eugenewang5425/MicroDinosaur/PROJECT_STATUS.md

# MicroDinosaur 项目状态

截至 2026-11-07。本页区分机械、台架测量和设计候选，不将通信或软件检查视为整机性能。

| 模块 | 已完成 | 当前限制与下一步 |
| --- | --- | --- |
| 机械/打印 | 当前 OS-M02 整机与 8 盘 30 件原生工程；四处 Ø1.8 mm 导孔修正与切片检查 | 相机孔距、卡扣、轴承及 M2 咬合待试装，承载和完整运动待验 |
| 校准架 | 已设计分体架体和可拔定位件，形成模型及打印文件 | 尚未实物试装，站立零位未实机测试；本包不混入姿态参考或工装试验副本 |
| IMU | F411 的静置/手动动作读取，ZERO 3W 的 250/250 次读取 | 两路都见约 ±15.6°/s 跳点；需核查上拉、读数一致性、波形及安装轴向 |
| 头部 HAT | 最新 B2 V3 六层工程；279 过孔，DRC 0 错误/0 警告/0 未连接 | 未打样；阻抗、载流、温升、电平、USB 改焊、驱动和整机空间待验证 |
| 感知 | 焊接修复后相机、NPU、Wi-Fi 及蓝牙功能复测正常；输入转换保真优化已完成 | 本周无新增持续帧率成绩；散热配件未购，安装后复测 5 分钟性能 |
| 站立/行走 | 已有调试与策略研究基础 | 现有 HAT 供电不兼容，实机策略测试推迟；不宣称站立或行走通过 |

## 最近的可核对测量

F411 在 5 µs 软件时序等待下静置读取 214/214 成功，手动动作 256/256 成功；ZERO 3W 约 5 秒读取 250/250 成功。事务成功不证明传感器精度或原子采样，原始异常点保留在 [IMU 数据](hardware/imu/README.md)。

感知固定为 640×360 相机、256×256 模型输入和 JPEG82。原生 INT8 输入搬运在既有对照中保持深度/JPEG 逐字节一致，配对净省约 10.72 ms/帧。裸板短测网页约 19.95 fps，但未通过完整 300 秒目标；热稳性能仍待散热后复测，详见 [感知说明](software/perception/README.md)。

## 当前发布范围

默认分支仅保留最新 CAD、打印工程、HAT 原生项目、对应主机代码、IMU 读取程序、当前感知代码与所用权重，以及少量最终验证结果。旧 CAD、旧仿真策略、历史对照、过程日志和工具环境不在当前文件树中；已经提交的历史可通过 Git 历史查看。

历史 v07 仿真使用独立模型、质量和控制定义，不能套用到 OS-M02。本次未把它作为当前模型附带，也未启动训练、访问电机或改变实机配置。
