eugenewang5425/MicroDinosaur/simulation/research/20260914_head_attitude/TABLES.md

# 全部确认组

| 条件/策略/任务/模式 | 完成/尝试 | 相机朝向RMS° | 周期偏航RMS° | 偏航角速RMS°/s | 俯仰RMS° | 横滚RMS° | 速度m/s | 跌倒 |
|---|---:|---:|---:|---:|---:|---:|---:|---:|
| head_mass_110pct__v7__straight__imu | 1/1 | 1.121 | 0.600 | 9.316 | 1.001 | 4.236 | 0.246 | 0 |
| head_mass_110pct__v7__straight__off | 1/1 | 3.022 | 1.392 | 20.574 | 2.555 | 5.333 | 0.246 | 0 |
| imu_40_60ms__v7__straight__imu | 1/1 | 2.326 | 1.580 | 22.623 | 1.537 | 5.559 | 0.230 | 0 |
| imu_40_60ms__v7__straight__off | 1/1 | 2.947 | 2.773 | 19.616 | 2.754 | 5.537 | 0.231 | 0 |
| imu_outage_200ms__v7__straight__imu | 1/1 | 2.330 | 0.676 | 9.445 | 1.266 | 5.432 | 0.230 | 0 |
| imu_outage_200ms__v7__straight__off | 1/1 | 5.160 | 1.437 | 19.895 | 2.740 | 5.552 | 0.231 | 0 |
| imu_residual_0p5deg_s__v7__straight__imu | 1/1 | 2.565 | 0.622 | 9.284 | 0.933 | 4.458 | 0.229 | 0 |
| imu_residual_0p5deg_s__v7__straight__off | 1/1 | 2.987 | 1.849 | 19.671 | 2.773 | 5.541 | 0.231 | 0 |
| motor_15ms__v7__straight__imu | 1/1 | 0.689 | 0.613 | 8.890 | 1.362 | 5.049 | 0.228 | 0 |
| motor_15ms__v7__straight__off | 1/1 | 3.056 | 1.449 | 18.796 | 2.684 | 5.871 | 0.229 | 0 |
| motor_5ms__v7__straight__imu | 1/1 | 1.200 | 0.914 | 10.842 | 1.110 | 4.367 | 0.225 | 0 |
| motor_5ms__v7__straight__off | 1/1 | 5.229 | 2.858 | 22.024 | 2.656 | 5.241 | 0.223 | 0 |
| nominal__s42_no_neck__left_then_hold__imu | 3/3 | 0.818 | 0.679 | 11.120 | 1.666 | 3.972 | 0.202 | 0 |
| nominal__s42_no_neck__left_then_hold__off | 3/3 | 2.186 | 1.964 | 26.473 | 3.177 | 3.910 | 0.204 | 0 |
| nominal__s42_no_neck__right_then_hold__imu | 3/3 | 0.928 | 0.801 | 12.243 | 1.968 | 4.006 | 0.203 | 0 |
| nominal__s42_no_neck__right_then_hold__off | 3/3 | 2.305 | 2.090 | 27.444 | 3.257 | 3.854 | 0.205 | 0 |
| nominal__s42_no_neck__stand__imu | 3/3 | 0.217 | 0.148 | 2.282 | 1.917 | 0.407 | 0.000 | 0 |
| nominal__s42_no_neck__stand__off | 3/3 | 1.437 | 0.390 | 1.604 | 4.572 | 0.421 | 0.000 | 0 |
| nominal__s42_no_neck__straight__filter_only | 3/3 | 2.846 | 2.022 | 14.231 | 3.059 | 5.073 | 0.270 | 0 |
| nominal__s42_no_neck__straight__imu | 3/3 | 0.895 | 0.722 | 12.085 | 2.294 | 4.334 | 0.270 | 0 |
| nominal__s42_no_neck__straight__off | 3/3 | 2.507 | 2.120 | 30.384 | 3.099 | 4.685 | 0.272 | 0 |
| nominal__v7__left_then_hold__imu | 3/3 | 0.797 | 0.703 | 7.519 | 0.682 | 3.708 | 0.167 | 0 |
| nominal__v7__left_then_hold__off | 3/3 | 3.917 | 2.630 | 19.579 | 2.975 | 4.406 | 0.167 | 0 |
| nominal__v7__right_then_hold__imu | 3/3 | 1.025 | 0.801 | 8.301 | 0.900 | 3.756 | 0.165 | 0 |
| nominal__v7__right_then_hold__off | 3/3 | 5.029 | 3.305 | 20.590 | 3.336 | 4.289 | 0.164 | 0 |
| nominal__v7__stand__imu | 3/3 | 0.494 | 0.111 | 1.463 | 0.516 | 1.892 | -0.000 | 0 |
| nominal__v7__stand__off | 3/3 | 1.903 | 0.002 | 0.082 | 1.321 | 2.793 | -0.000 | 0 |
| nominal__v7__straight__filter_only | 3/3 | 4.349 | 1.428 | 12.230 | 2.838 | 5.386 | 0.227 | 0 |
| nominal__v7__straight__imu | 3/3 | 1.372 | 0.617 | 9.137 | 0.970 | 4.429 | 0.230 | 0 |
| nominal__v7__straight__off | 3/3 | 4.567 | 1.467 | 19.807 | 2.752 | 5.544 | 0.231 | 0 |
| physics_0p625ms__v7__straight__imu | 1/1 | 1.423 | 0.627 | 9.101 | 0.918 | 4.395 | 0.231 | 0 |
| physics_0p625ms__v7__straight__off | 1/1 | 4.096 | 1.458 | 19.561 | 2.776 | 5.505 | 0.229 | 0 |
| pitch_scan__v7__straight__imu | 1/1 | 1.284 | 0.624 | 9.250 | 2.498 | 4.470 | 0.230 | 0 |
| position_40ms__v7__straight__imu | 1/1 | 0.807 | 0.514 | 7.157 | 0.956 | 4.515 | 0.226 | 0 |
| position_40ms__v7__straight__off | 1/1 | 2.765 | 1.145 | 14.999 | 2.534 | 5.683 | 0.225 | 0 |
| roll_scan__v7__straight__imu | 1/1 | 1.240 | 0.623 | 9.154 | 0.953 | 4.364 | 0.230 | 0 |
| yaw_scan__v7__straight__imu | 1/1 | 7.106 | 4.918 | 10.754 | 0.999 | 4.353 | 0.230 | 0 |
