eugenewang5425/MicroDinosaur/simulation/research/20260914_run_jump/PLAN.md

# 跑跳专项，2026-09-14

用户最新指令：台阶训练暂时不管，转向跑跳。ToF、台阶专家接管与视觉触发工作暂停。

本轮建立两个独立专项模型，原生产模型冻结。共享起点为 `microdinosaur_demo_demonstration/20260914_train_512x101/model_16250.pt`，源文件不改；不再加旧技能教师约束，避免要求一个模型同时保留所有旧动作。

## 两个任务

- **run**：平地0.45–0.80m/s指令，0–1秒站立、1–7秒加速行走、7–10秒发出停止请求；保留速度/航向/足部评分并增加小幅腾空奖励。实际速度与双脚腾空分开记录，没有腾空只称快走。
- **jump**：6秒一轮，0–1.5秒身体Z指令−3cm，1.5–2.2秒＋2cm，随后回零。没有示范关节轨迹、外力弹射或空中出生；从已校准站立状态探索蹬伸。奖励上升速度最大进展、合格姿态下无支撑时间最大进展与腾空后的落稳，不因抬脚本身认定跳跃，不重复支付旧的最大进展。

继续81维输入、19关节输出，nominal Kp7/Kd0.8（协议编码后7.0156/0.800299），物理步1.25ms、控制20ms、电机目标5–15ms、位置20–40ms、速度20ms。S288力矩随机降额范围0.48–0.60Nm；增益、质量/惯量、摩擦、编码器与IMU扰动保留。没有零延迟/零阻尼或ERPO。头部IMU继续负责头姿态，头yaw采用编码器基准，pitch/roll保持策略基准与IMU修正。

使用当前v07视觉包络生成的既有保守身体地面碰撞盒；质量仍1.0982148kg，未修改CAD。身体接地终止该次跑跳，不把头/尾支地算腾空或正常落地。碰撞盒不是完整关节自碰撞和实物强度证明。三个3秒站立物理检查通过，未接触身体代理，倾斜0.77–0.87°。

## 训练与事先固定的验收

两次64×5短训已完成并导出归一化ONNX。正式固定LR1e-4，小跳seed51、512×401；快速运动seed52、512×301。两项均有迭代上限、数值异常中止和来源快照；发现失败保留原记录。

CPU使用同一个带碰撞代理的物理模型和完整现有头部/机身IMU外环。原策略与候选使用相同命令时序和未用于训练的初态101/102/103，5/10/15ms电机目标延迟。

- 真正腾空：所有机器人地面支撑力合计低于0.05N，两只完整足部碰撞网格均高于地面2mm，姿态倾斜小于30°；连续至少40ms，失去支撑时整机质心上升速度至少0.1m/s。2mm条件用于排除微小接触闪断，不能单看contact flag。后期开发抽查明确将上升速度测量点由躯干细化为整机质心，避免躯干相对运动冒充整机跳跃；原门槛数字未放宽，保留改前/改后记录。
- 小跳成功：满足上述腾空、末1秒平均平面速度低于0.03m/s且倾斜低于15°，超过90%的末段时间双脚接地，未倒、身体未支地、关节限位容差不超过0.02rad。
- 快速运动分别报告2–7秒实际速度、航向与头部姿态、停止残余运动和腾空段。实际速度超过0.35m/s且有合格腾空、无上述运动失败，才标记本轮“带腾空跑动”；该局部定义不等于成熟跑步技能。
- 额外敏感性：0.625ms细步长；11.1V/9.9V下已有暂定速度—力矩包络；位置反馈40ms、地面摩擦0.6、头部载架刚体质量/惯量＋10%、反馈随机丢包2%，分别改变。包络形状及若干范围尚未实测辨识，属于CPU压力对照，未声称GPU已训练全部情景。基线和候选均记录这些条件。

此前3次脚本伸腿无腾空，本轮源模型名义快速运动复测约0.304m/s、无腾空；源模型相同跳跃命令也未腾空。因此“准备任务/奖励变高”和“实际跳起来”必须分开报告。

输出代码：`run_jump_cfg.py`、`prepare_run_jump.py`、`test_run_jump.py`、`evaluate_run_jump.py`，以及复用的 `train_terrain_skill.py --skill run|jump`。旧入口名称保留兼容，不代表本轮继续台阶训练。

## 后续开发干预记录

正式小跳专家能够腾空但末段未停稳后，追加固定2.8秒交回冻结v7的CPU组合动作试验，保留全部物理/传感/动作历史。该项不是最初预定配方，不归因于RL更新；先对原矩阵逐值复核切换前轨迹，再冻结交还时刻，用新初态201–203 × 5/10/15ms确认。完整结果与不足见[RESULTS.md](RESULTS.md)，其中开发集和新初态分别报告。
