eugenewang5425/MicroDinosaur/source/microduck_rl/MODEL_LICENSE_NOTE.md

# Microduck model attribution

Current MicroDinosaur geometry contains derivatives of the Microduck digital blueprint from `pollen-robotics/microduck_rl`, revision `29e887ecfbf5d37144759e5a9f8a176dfb83d547`.

The locally retained upstream README ends with the following notice:

> This project is licensed under the Apache 2.0 License. See the LICENSE file for details.
> 3D model files are licensed under Creative Commons BY-SA-NC.

The README does not specify a Creative Commons version. This repository preserves the upstream wording and does not assign a different license to derived model geometry. The accompanying `LICENSE` is the upstream Apache-2.0 code license; it is not a replacement license for the 3D files.

The complete upstream sources remain local and are not part of this latest-model-only upload. Source README at the recorded revision: https://github.com/pollen-robotics/microduck_rl/blob/29e887ecfbf5d37144759e5a9f8a176dfb83d547/README.md
