eugenewang5425/MicroDinosaur/current/previews/head_imu_closed.png

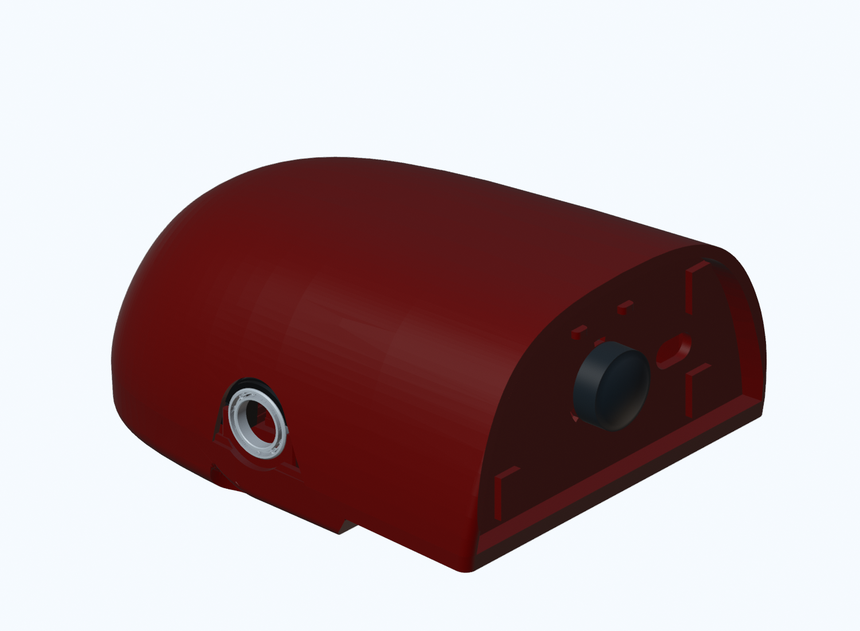
current/previews/head_imu_closed.png
