eugenewang5425/MicroDinosaur/current/previews/head_imu_top.png

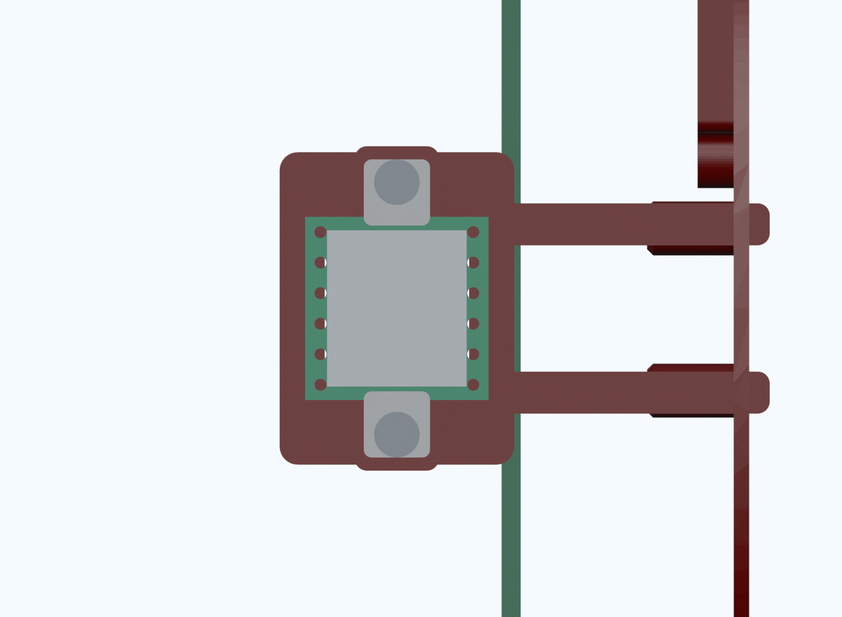
current/previews/head_imu_top.png
