eugenewang5425/MicroDinosaur/simulation/research/20260914_run_jump/comparison.png

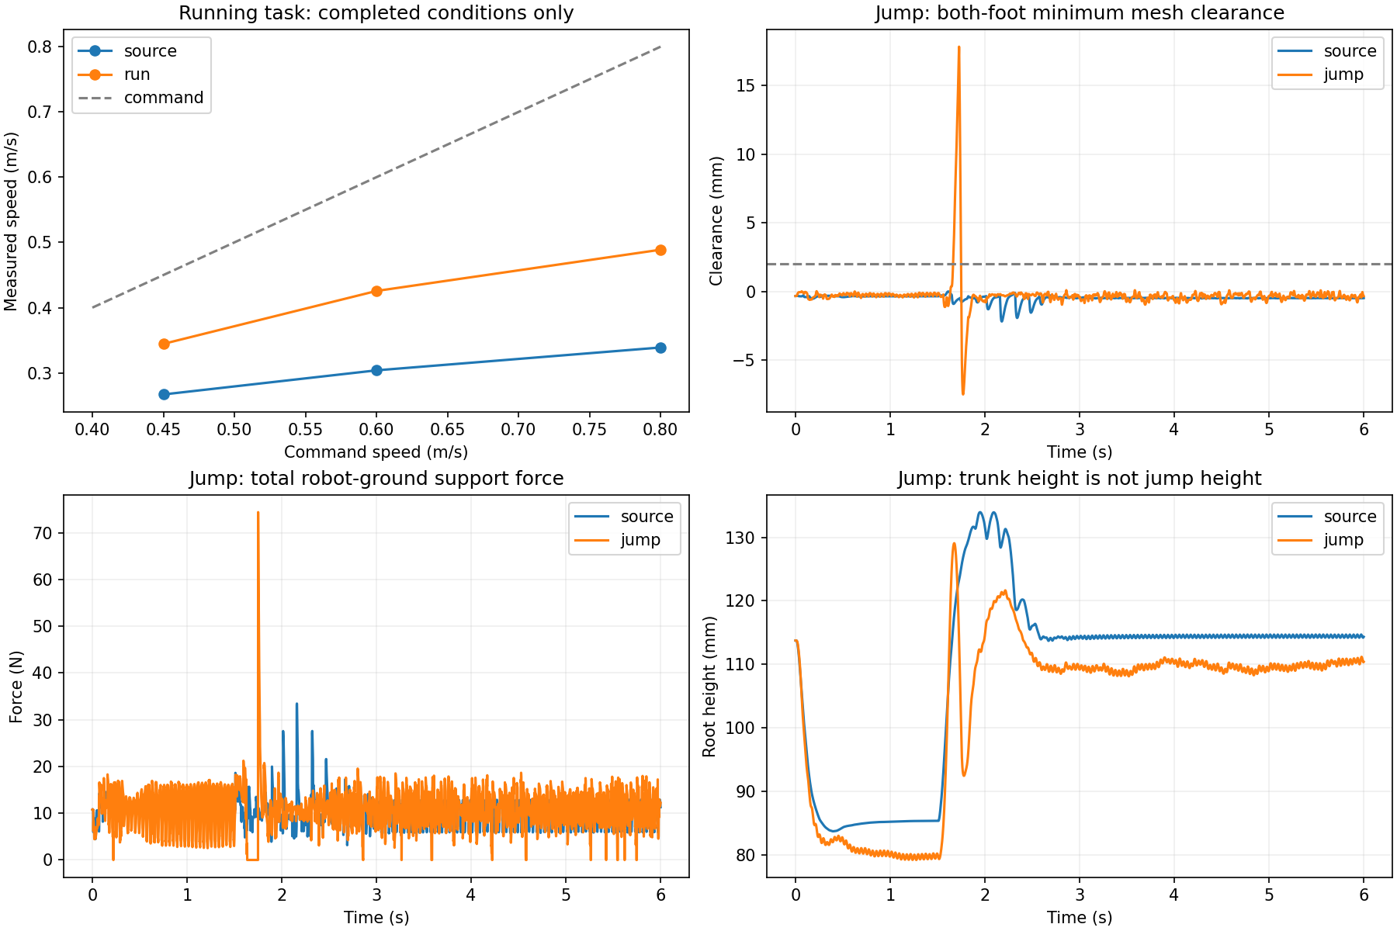
simulation/research/20260914_run_jump/comparison.png
