eugenewang5425/MicroDinosaur/current/calibration_fixture/TailStand.stl

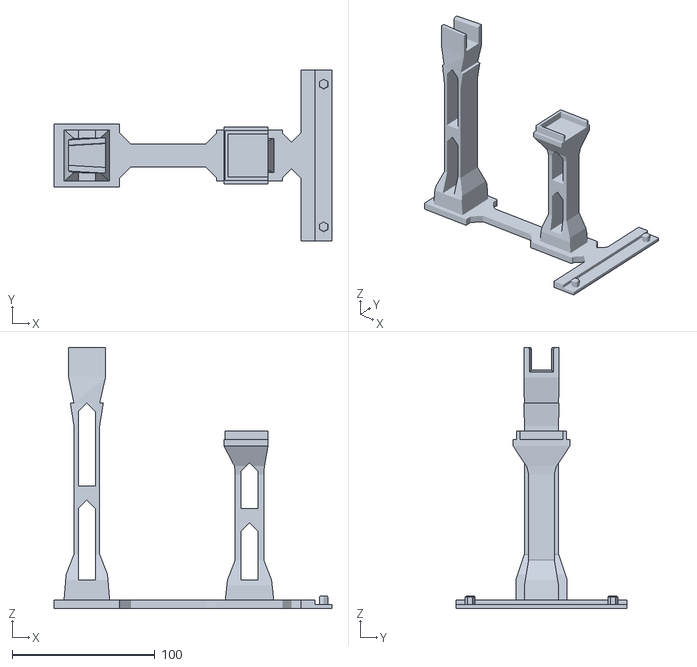
[picture p9: CAD file, 2026-11-08]
current/calibration_fixture/TailStand.stl
194.8 x 120.0 x 183.1
