eugenewang5425/MicroDinosaur/current/calibration_fixture/BodyStand.stl

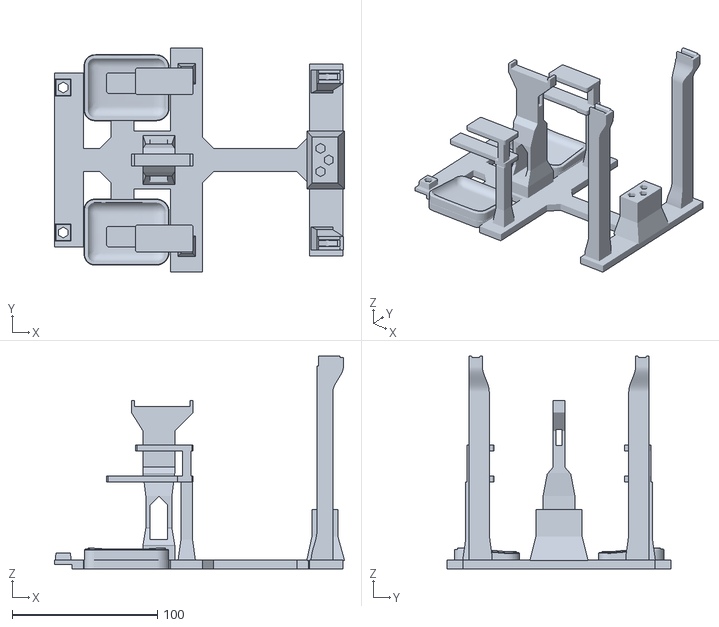
[picture p10: CAD file, 2026-11-08]
current/calibration_fixture/BodyStand.stl
200.0 x 154.2 x 146.6
