eugenewang5425/MicroDinosaur/current/calibration_fixture/HeadNeckColumn.stl

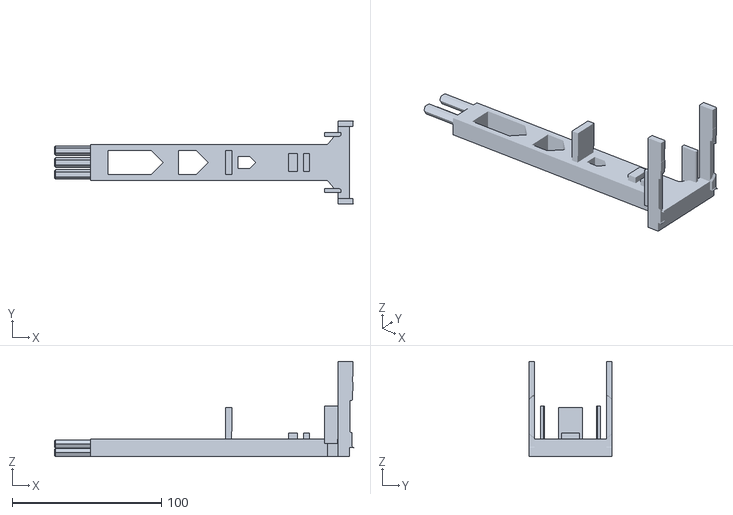
[picture p11: CAD file, 2026-11-08]
current/calibration_fixture/HeadNeckColumn.stl
200.7 x 56.0 x 64.0
