eugenewang5425/MicroDinosaur/(list of files, cad)

Other CAD files:
current/calibration_fixture/WholeBodyFixture_TwoPlates.3mf
current/calibration_fixture/WholeBodyFixture_Assembly.3mf
current/MicroDinosaur_Print.3mf
current/calibration_fixture/Print_Tail_Module.3mf
current/calibration_fixture/Print_Body_Module.3mf
current/MicroDinosaur_Current.blend
current/calibration_fixture/WholeBodyZeroJig.blend
