eugenewang5425/MicroDinosaur/current/previews/assembly_three_quarter.png

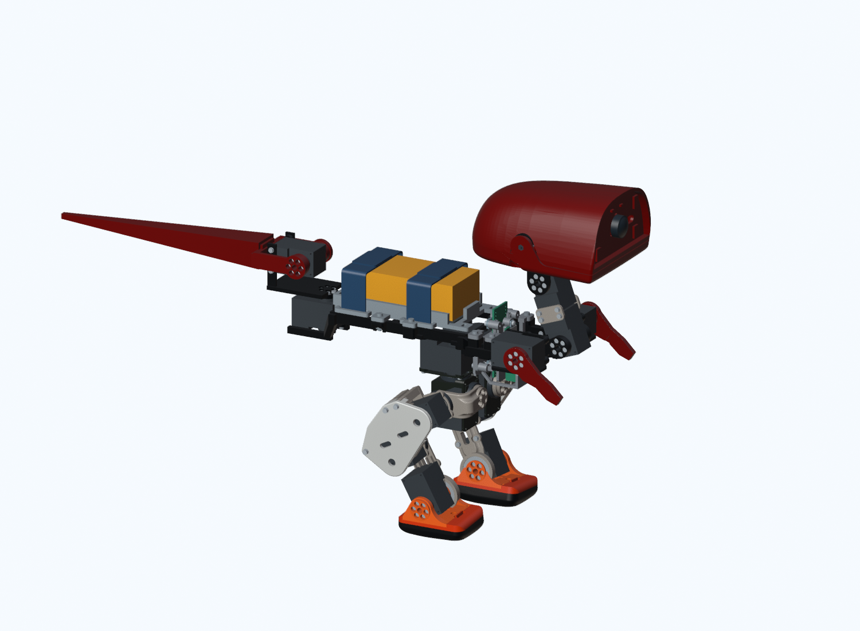
current/previews/assembly_three_quarter.png
