eugenewang5425/MicroDinosaur/simulation/research/20260914_head_attitude/EXPERIMENT.md

# 头部IMU姿态控制：固定步态实验

用户目标是相机运动时基本面向期望前方，减少无指令左右转头；接受结构导致的周期横向平移。此次让头部IMU实际参与三个头部舵机的反馈控制，不只记录数据。

## 控制职责与可观测信息

机身IMU外环保持原样，通过用户wz命令通道纠正身体航向。头部IMU独立提供三轴gyro/加速度/源时间戳，沿用静止零偏校准及加速度门控的四元数估计。颈部四个编码器和CAD局部旋转用于初始化头、身共同航向，以及求头部俯仰/偏航/横滚关节的角运动雅可比；运行时使用量化后的延迟编码器，不读取世界姿态真值来控制。

头部目标为导航期望航向、水平俯仰和水平横滚。有主动看向命令时叠加相应角度并平滑改变；导航目标随用户转向更新，不锁死在起步前方。头部角度误差与gyro角速度反馈经阻尼逆映射到三个关节的有界位置补偿，经过既有动作滤波、电机延迟、S288量化和力矩限制。neck_pitch、双腿、尾巴、双臂、下颌仍由原步态策略控制；不设相机横向位置目标。

两路IMU各自积分的yaw零点原本独立，不能直接相减声称是同一航向。此次在稳定站立校准结束时，以CAD运动学、实测编码器和机身倾斜估计求头部相对机身偏角，再对齐头部积分零点。其准确度仍受实际安装外参和编码器偏置影响。

## 参数冻结与对照

开发只用v7、初态seed0、12秒直走。第一组5次测试降低了摆幅但略增加偏航角速度，完整保留在development。第二组6次测试检查gyro反馈、反馈滤波和头部目标滤波，保留在development_followup。选择100ms头部策略目标滤波后冻结参数，具体值及源码哈希见plan.json。该100ms是软件低通时间常数，不是新增100ms传感器运输延迟。

正式73次尝试：两份固定策略，各三个独立确认初态；直走有原方案/仅头部滤波与限幅/头部滤波加IMU反馈三组，站立和左右转后保持有原方案/头控两组，共54次。另有16次物理步长、工作电机延迟、编码器延迟、IMU慢数据、丢帧、残余偏置、头部质量扰动探针，以及3次主动头部yaw/pitch/roll命令测试。除静止8秒外每次12秒，之前均用v7站立6秒校准，候选在校准后切换且保留动作/延迟历史。源码冻结期间任何改变使运行失败；校准失败单列，禁止删去。

主要比较相机朝向误差、去趋势周期偏航、光轴偏航角速度、俯仰/横滚及前进速度，并记录头部舵机力矩、限幅和跌倒。三个seed是同权重的评估初态，不是三份训练重复。软件目标滤波也会改善角速度，必须单列其作用，不能全归于IMU。

## 物理与证据边界

名义条件：CAD v07、19×S288、约1098.2g名义质量、kp7/kd.8，50Hz策略；物理步长1.25ms；电机/位置/速度延迟10/20/20ms；双IMU20ms采样和20ms运输。没有零阻尼或零延迟优化，没有重训或移植ERPO。力矩上限.6Nm沿用原模型；实测电机曲线、温升、电源动态和全身碰撞仍未辨识。额外头部控制器仅在仿真主机执行，尚未在F411/Pi上测量计算时间与串口吞吐。

头部IMU使用与上一轮一致的噪声/量化/延迟假设，不冒充JY61P实测固件AHRS。六轴积分仍会受yaw零偏漂移影响；步态actor原有projected_gravity仍使用仿真旋转，整条实机感知链尚未完成。

传感器坐标约定依据[MuJoCo gyro文档](https://mujoco.readthedocs.io/en/stable/XMLreference.html#sensor-gyro)；静止零偏与加速度拒绝机制参考[X-IO Fusion官方说明](https://github.com/xioTechnologies/Fusion)。本实现没有调用其库，也不等同于JY61P内置算法。
