eugenewang5425/MicroDinosaur/simulation/research/20260914_run_jump/RESULTS.md

# 独立跑跳专项首轮结果（2026-09-14）

台阶与ToF训练已暂停。本轮完成两个独立专家的正式RL训练，共 **8,626,176次环境转移**。快速运动专家明显提速，但仍是没有双脚腾空的快走；小跳专家出现可测量的腾空，固定时间交回冻结v7后能停稳。两者仍是研究候选，原生产模型未替换。

## 速度与停止

每档9个计划条件：3个初态101/102/103 × 5/10/15ms电机目标延迟。原策略与新策略均有同一个5ms/seed102启动校准拒绝，速度均值使用各自其余8条；失败保留在计划分母。原策略是共同续训起点model_16250对应ONNX，不是生产p2或v7校准器。

| 前进指令 | 原策略实速 | 快速运动专家实速 | 提升 | 原策略/专家停稳 | 专家带腾空跑动 |
|---|---:|---:|---:|---:|---:|
| 0.45m/s | 0.267m/s | 0.344m/s | 29.0% | 7/9 → 3/9 | 0/9 |
| 0.60m/s | 0.304m/s | 0.426m/s | 40.0% | 6/9 → 3/9 | 0/9 |
| 0.80m/s | 0.339m/s | 0.489m/s | 44.2% | 7/9 → 3/9 | 0/9 |

实速取2–7秒机身前向速度均值，包含既有机身IMU航向外环。新专家24条已执行名义条件均未倒、未身体支地、未关节越限。7秒请求停止，末1秒残余平面速度平均 **0.0387m/s**，范围0.0195–0.0542m/s；停稳总计9/27，低于原策略20/27。不能把提速称为完整跑停技能。

相机朝向RMS按完整10秒记录、再对初态和延迟取均值：三档原策略0.47/0.51/0.78°，新专家0.87/1.07/1.03°；新专家俯仰RMS1.28/1.28/1.61°。速度收益伴随部分朝向退步，头部IMU仍保持开启。

## 小跳与独立专家交还

命令为0–1.5秒下蹲请求−3cm，1.5–2.2秒抬高请求＋2cm，随后回零。没有关节示范、外力弹射或空中出生。专项自己学到蹬伸，动作幅度以实际轨迹为准。

| 方案 | 计划/完成运动 | 合格腾空 | 完整小跳通过 | 主要失败 |
|---|---:|---:|---:|---|
| 同源原策略 | 9/8 | 0 | 0/9 | 无腾空；2条跌倒，另1条启动拒绝 |
| 训练后小跳专家单独运行 | 9/8 | 8 | 0/9 | 全部末段未停稳，另1条启动拒绝 |
| 专家＋2.8秒交回冻结v7 | 9/8 | 8 | 8/9 | 1条启动拒绝 |
| 同一交还方案，新初态201–203 | 9/9 | 9 | **7/9** | 2条起跳关节越限 |

**10ms/seed101例子**：所有机器人地面支撑力低于0.05N达115ms，其中两只完整足部网格均高于地面2mm且姿态合格的连续时间为 **83.75ms**。失去支撑时整机质心上升速度0.399m/s，腾空质心最高点比起飞点高 **8.10mm**。足底同时离地最大间隙17.82mm，包含收腿造成的变化；躯干抬升也不能直接当跳高。

小跳专家单独运行的8条名义条件，末1秒残余速度均值42.15mm/s。加入交还后，相同8条均值降至4.94mm/s；上述代表条件由40.09降至0.327mm/s。交还仅更换ONNX会话，qpos/qvel、动作和指令延迟历史、观测历史、头部补偿与航向参考/积分均连续，切换前后指纹相同；交还前物理轨迹与原独立专家逐值一致。没有重置机器人来制造停稳。

交还方案是在独立专家落稳失败后追加的开发干预，随后才固定时间2.8秒，以新初态201–203复核。新初态的2个失败分别在1.66625/1.66375秒起跳时，关节超过限位0.04222/0.03190rad，均早于交还；虽然9条都腾空、落地并停稳，仍只记7/9通过。这9条不是训练初态，也没有根据结果调交还时间。

这是固定命令时序的组合动作验证，尚未接上自主感知触发或真实固件。原地跳跃没有前进指令，现有机身航向外环受moving门控而不主动输出纠偏；头部IMU继续保持相机方向。代表条件相机朝向RMS2.10°、俯仰2.66°，但机身航向RMS22.32°、最终偏8.23°，不能称为机身航向也稳定。

## 配件物理与压力条件

保留当前CAD v07、19个S288和1.0982148kg名义质量；Pi Zero 2W/F411、双JY61P及3S电池沿用现有执行约束。策略仍81→19，头部gyro不加入actor。名义Kp7/Kd0.8，协议编码后7.015610568/0.80029928；物理1.25ms、策略20ms、电机目标5–15ms、位置反馈20–40ms、速度反馈20ms。GPU保留力矩0.48–0.60Nm降额、增益、质量/惯量、摩擦、编码器与IMU扰动。没有零延迟/零阻尼调优或ERPO。

新增专项采用已有当前CAD保守身体地面碰撞代理，身体触地终止。CPU与GPU均使用30/50次求解迭代、相同步长与积分器/接触锥设置。三个3秒站立检查通过。这不等于完整连续自碰撞、关节实际装配行程、足垫材料或冲击强度已被辨识。

每个压力条件单独改变一个配置，使用seed104。下表均指“小跳专家＋固定v7交还”；快走和同源原策略也保留了相同7项压力对照。

| 条件 | 双脚净空腾空 | 小跳结论 |
|---|---:|---|
| 物理步长0.625ms | 86.88ms | 失败：关节越限0.03276rad |
| 暂定转速—力矩包络，11.1V | 37.50ms | 失败：低于40ms门槛 |
| 同一暂定包络，9.9V | 0ms | 失败：未腾空 |
| 位置反馈40ms | 82.50ms | 通过 |
| 地面摩擦0.6 | 87.50ms | 失败：关节越限0.05504rad |
| 头部载架刚体质量/惯量＋10% | 81.25ms | 通过 |
| 反馈随机丢包2% | 85.00ms | 通过 |

7项压力条件均能落稳且未倒，但完整小跳只有3/7通过。快走在这些条件下实速0.406–0.437m/s，无腾空/跌倒/越限，停止均未达标。

**实际数值风险**：代表跳跃峰值支撑力74.41N，峰值关节力矩达到0.60Nm上限，峰值关节速度14.61rad/s；落地期间足部网格最低点达到地面以下7.51mm。当前MuJoCo软接触与求解模型允许这种穿透，它不是实物足垫压缩的验证。细步长仍有腾空但触发限位失败，不能据此宣称数值已收敛。电压/转速包络是既有未辨识假设，只用于CPU敏感性试验，GPU本轮并未学习该动态包络。功耗、热、回灌、齿隙/柔性和实际电源压降仍不能从本轮RL推出。

## 训练和审计证据

| 专项 | 环境×更新 | 新增转移 | 固定实际学习率 | 最终检查点 |
|---|---:|---:|---:|---|
| 小跳，seed51 | 512×401 | 4,927,488 | 1e-4 | model_16650.pt |
| 快速运动，seed52 | 512×301 | 3,698,688 | 1e-4 | model_16550.pt |

共同起点为本地检查点 `logs/rsl_rl/microdinosaur_demo_demonstration/20260914_train_512x101/model_16250.pt`，该大文件未随仓库发布。移除旧技能教师保留损失，使用现有PPO及81维镜像损失，两项独立存档。两次64×5短训另有15,360次转移，不混入正式计数。训练未中断，权重/TensorBoard标量有限；环境计数与优化器步数增量核对通过，成本项符号正确。7项单元测试覆盖命令时序、奖励历史/reset、腾空与整机质心判据、正阻尼和延迟。

归一化ONNX导出保持81→19，用270条锚点派生观测对PyTorch手动归一化和前向进行比较，两模型最大差异均为4.18e-7以内。原生产策略（未随仓库发布）前后SHA256均为 `0804114efd1e457ec2c297d709c0464fd0c2bfe251cbb36db7de74543857b0e3`。

本轮正式矩阵127条记录（含明确的重复名义对照），118条完成运动，9条在候选执行前被静止IMU校准拒绝；另4条quick/中途开发探针。各阶段失败均保留。两条原策略视频曾因缺少cv2失败，随后用已有imageio/Pillow从原qpos重绘，原物理记录哈希未变，见视频修复审计。腾空指标在开发中由躯干速度细化为整机质心起飞速度，52条既有记录从原轨迹重算，成功/失败判定改变0条；没有重跑挑选更好的物理结果。

模型与材料：

- [快速运动 ONNX](../../policies/fast_walk_candidate.onnx)，SHA256 `f985cd322db6181dc9bacdb049dd764e268f27963a9bb54ccff9bd5651d162fc`。
- [小跳 ONNX](../../policies/jump_candidate.onnx)，SHA256 `bbfc57748af64a3bee9fffc45825cbb6e816c7f2bd351e885683b3ef750dc5cf`。
- 交还与启动使用冻结 `research/20260913_handoff/v7_reference.onnx`，SHA256 `53120a401d02f124b35361d791eb74748a7601550c701c511d62cbad9cddff96`，与生产p2分开。
- [2.5倍慢放的小跳与交还](evaluation/jump_return/jump_return_slow.mp4)、[0.8m/s指令快走原速视频](evaluation/run/fast_walk.mp4)、[前后物理曲线](comparison.png)。
- [预定配方/验收](PLAN.md)、[全部条件CSV](conditions.csv)、[结构化汇总](summary.json)、[训练/导出审计](training_audit.json)、[7项测试](tests.log)、[物理预检](physics_precheck.json)。
- [腾空测量修订](measurement_refinement.json)、[原视频修复审计](evaluation/source/video_repair_audit.json)、[最终视频物理不变审计](video_audit.json)、[来源与产物清单](manifest.json)。

## 复核入口与下一轮

本仓库发布冻结结果、ONNX 和视频，不发布当时的完整检查点池及临时评估脚本。复核现有证据从仓库根目录读取本目录的 CSV、JSON、视频和策略哈希；如需续训，应先用 `simulation/training/` 建立新环境并提供自己的起始检查点。

正式训练入口为 `train_terrain_skill.py --skill jump --checkpoint <共同起点> --out <新的独立目录> --envs 512 --iterations 401 --seed 51 --learning-rate 0.0001`；run对应301次、seed52。旧脚本名保留兼容，不意味着训练台阶。每个训练目录的 `run_provenance.json`、`source_snapshot/`、`params/` 保留当次实际配置，后续不要用新配置追溯解释旧模型。

下一轮优先修正起跳限位余量、落地软接触/冲击与低输出条件，保持本轮失败集；快走处理停止交还，再逐步探索连续腾空跑动。继续采用基本步态与动作专家分工，台阶保持暂停。尚未部署硬件或替换生产策略。
