eugenewang5425/MicroDinosaur/hardware/head_hat/kicad/HEAD_A0.kicad_pcb

## KiCad design hardware/head_hat/kicad/HEAD_A0.kicad_pcb (2026-11-07)

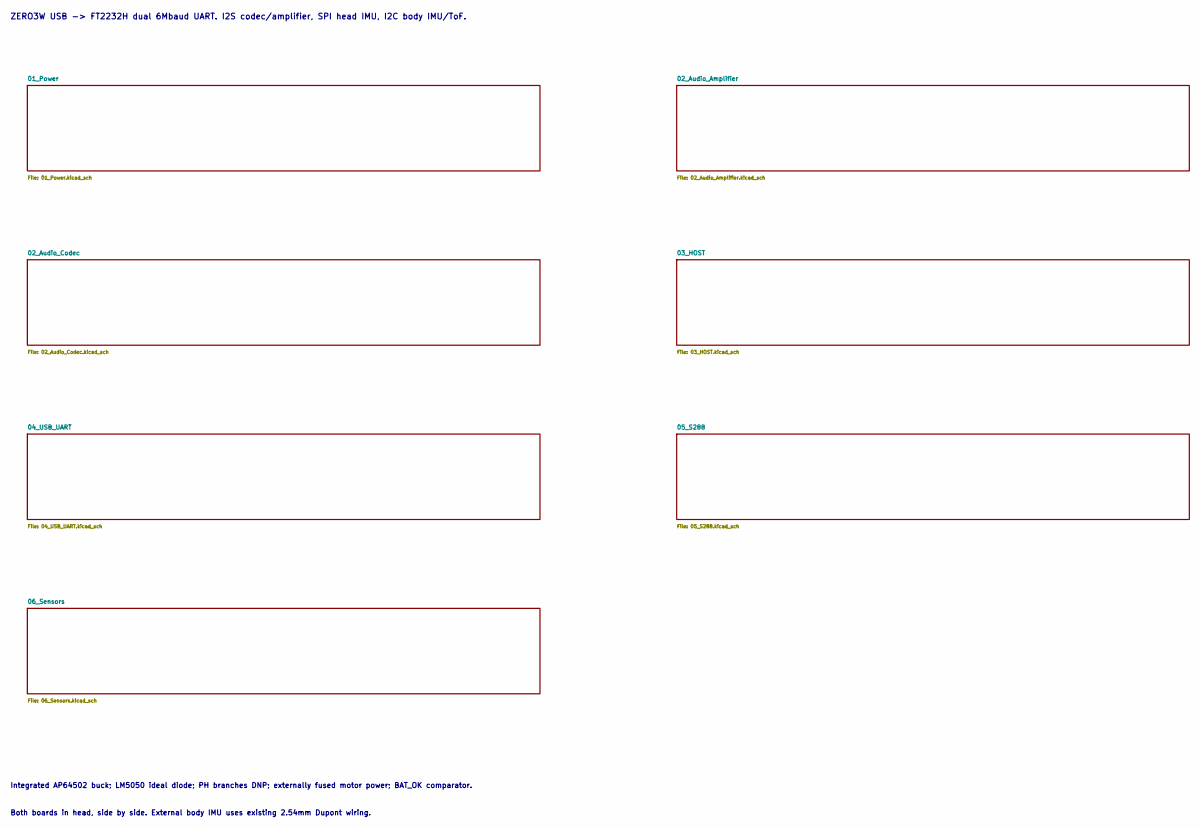
[picture p18: schematic HEAD_A0.kicad_sch, HEAD B2 / 65x30mm / 6L]

Notes on the sheet:
ZERO3W USB -> FT2232H dual 6Mbaud UART. I2S codec/amplifier, SPI head IMU, I2C body IMU/ToF.
Integrated AP64502 buck; LM5050 ideal diode; PH branches DNP; externally fused motor power; BAT_OK comparator.
Both boards in head, side by side. External body IMU uses existing 2.54mm Dupont wiring.

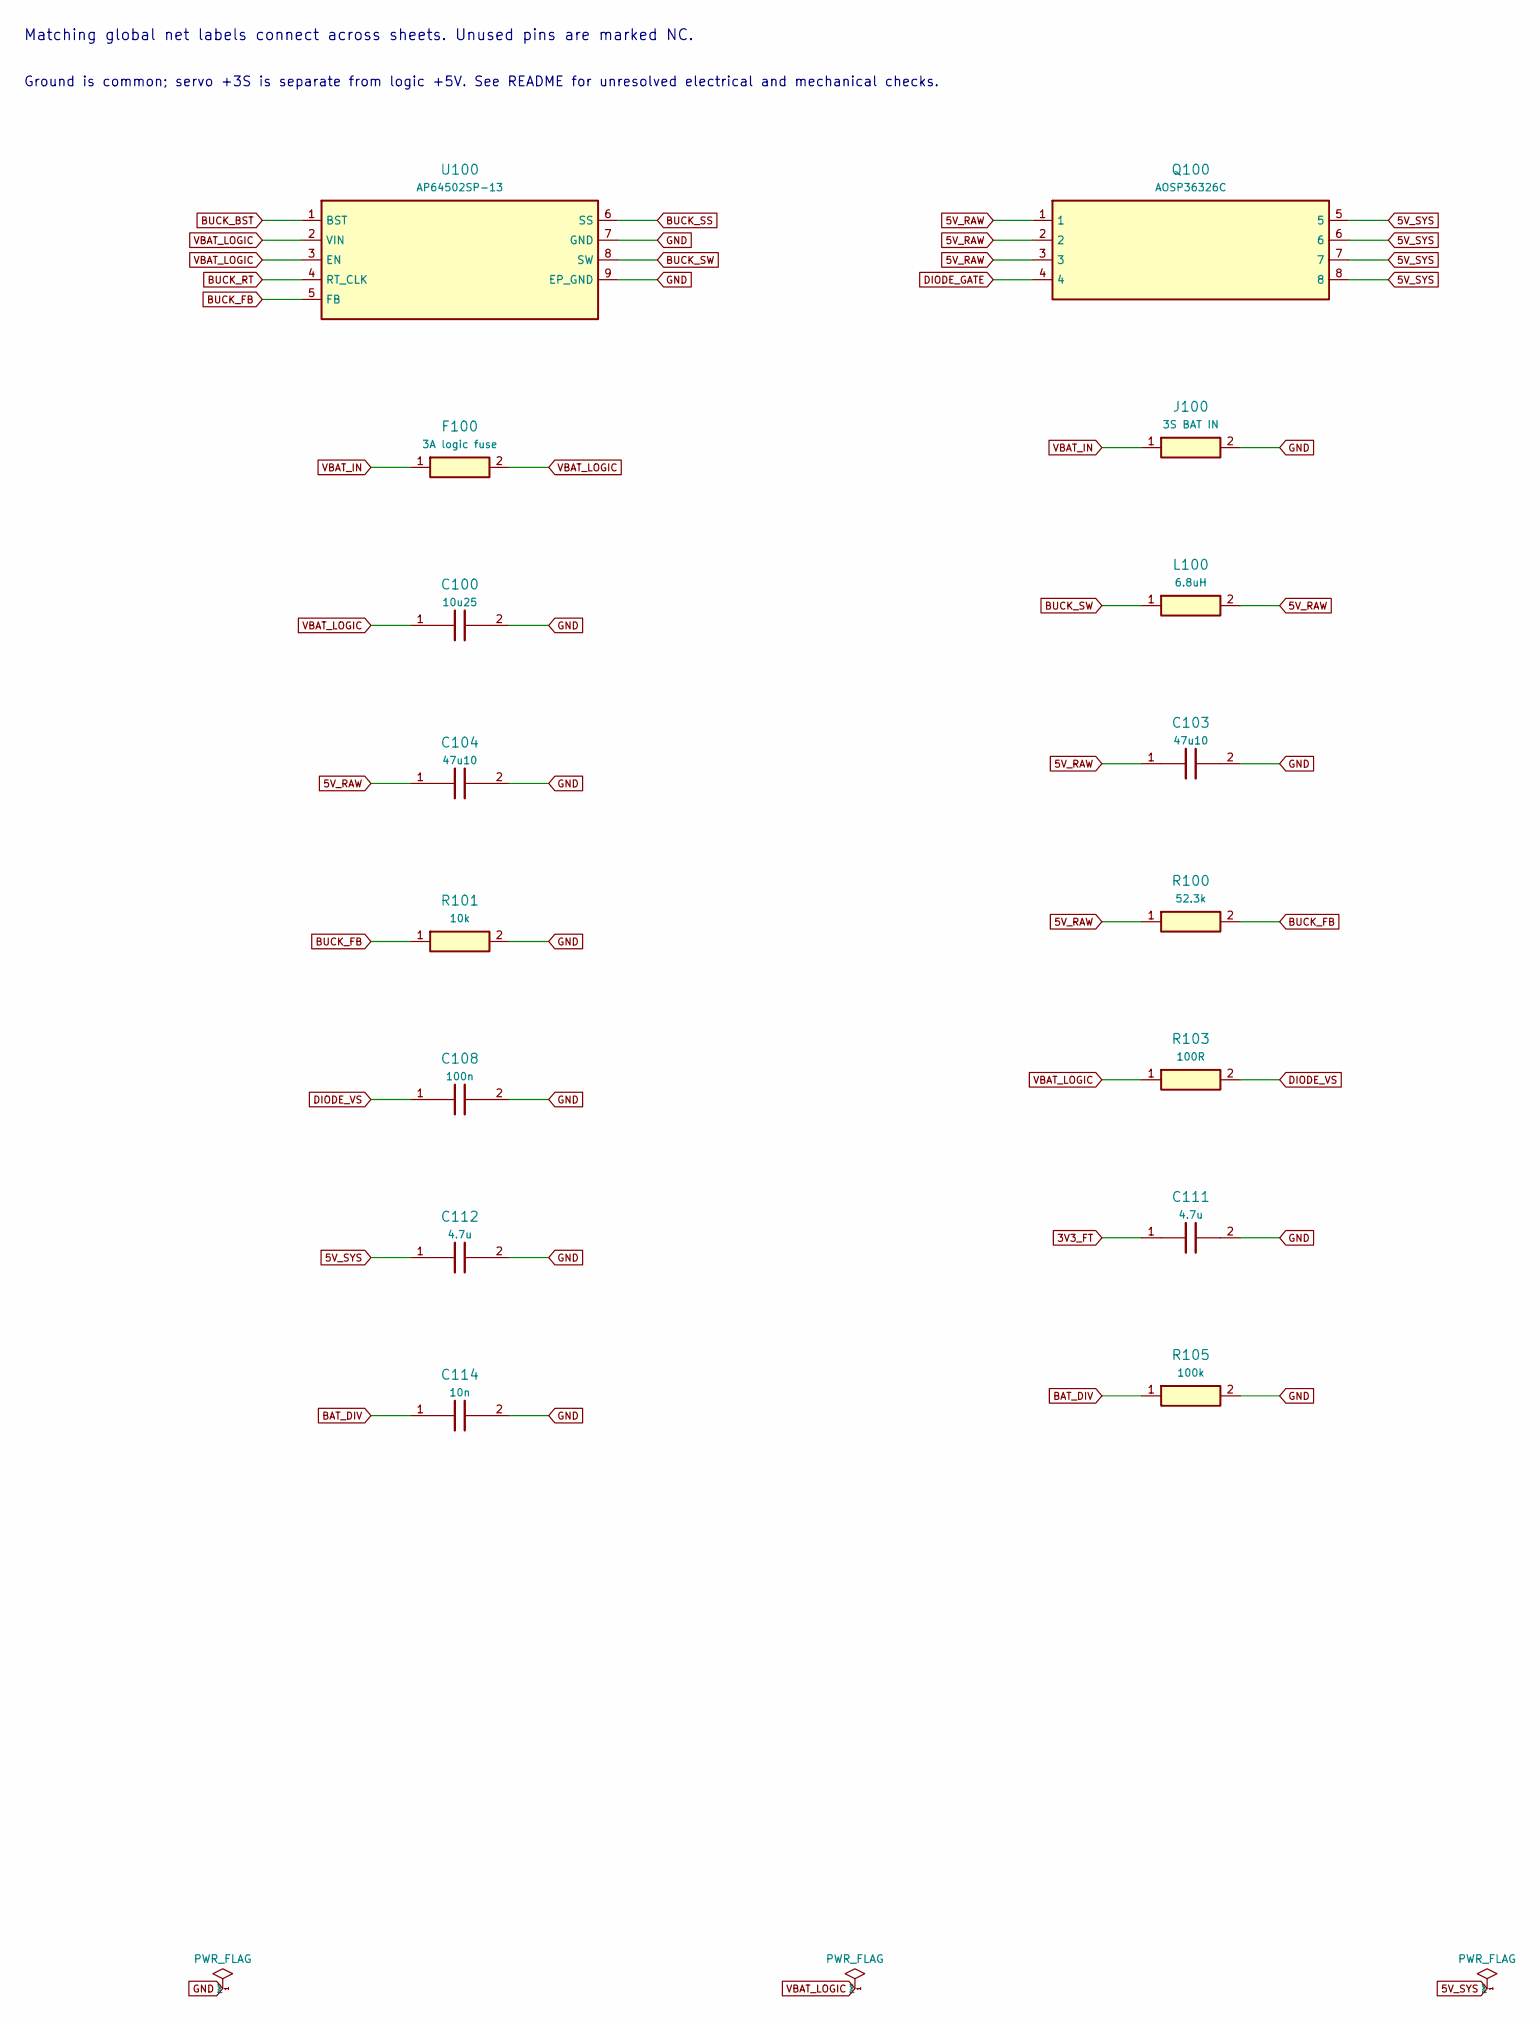
[picture p19: schematic 01_Power.kicad_sch, 01_Power | HEAD B2 / 65x30mm / 6L, part in row 1, column 1]

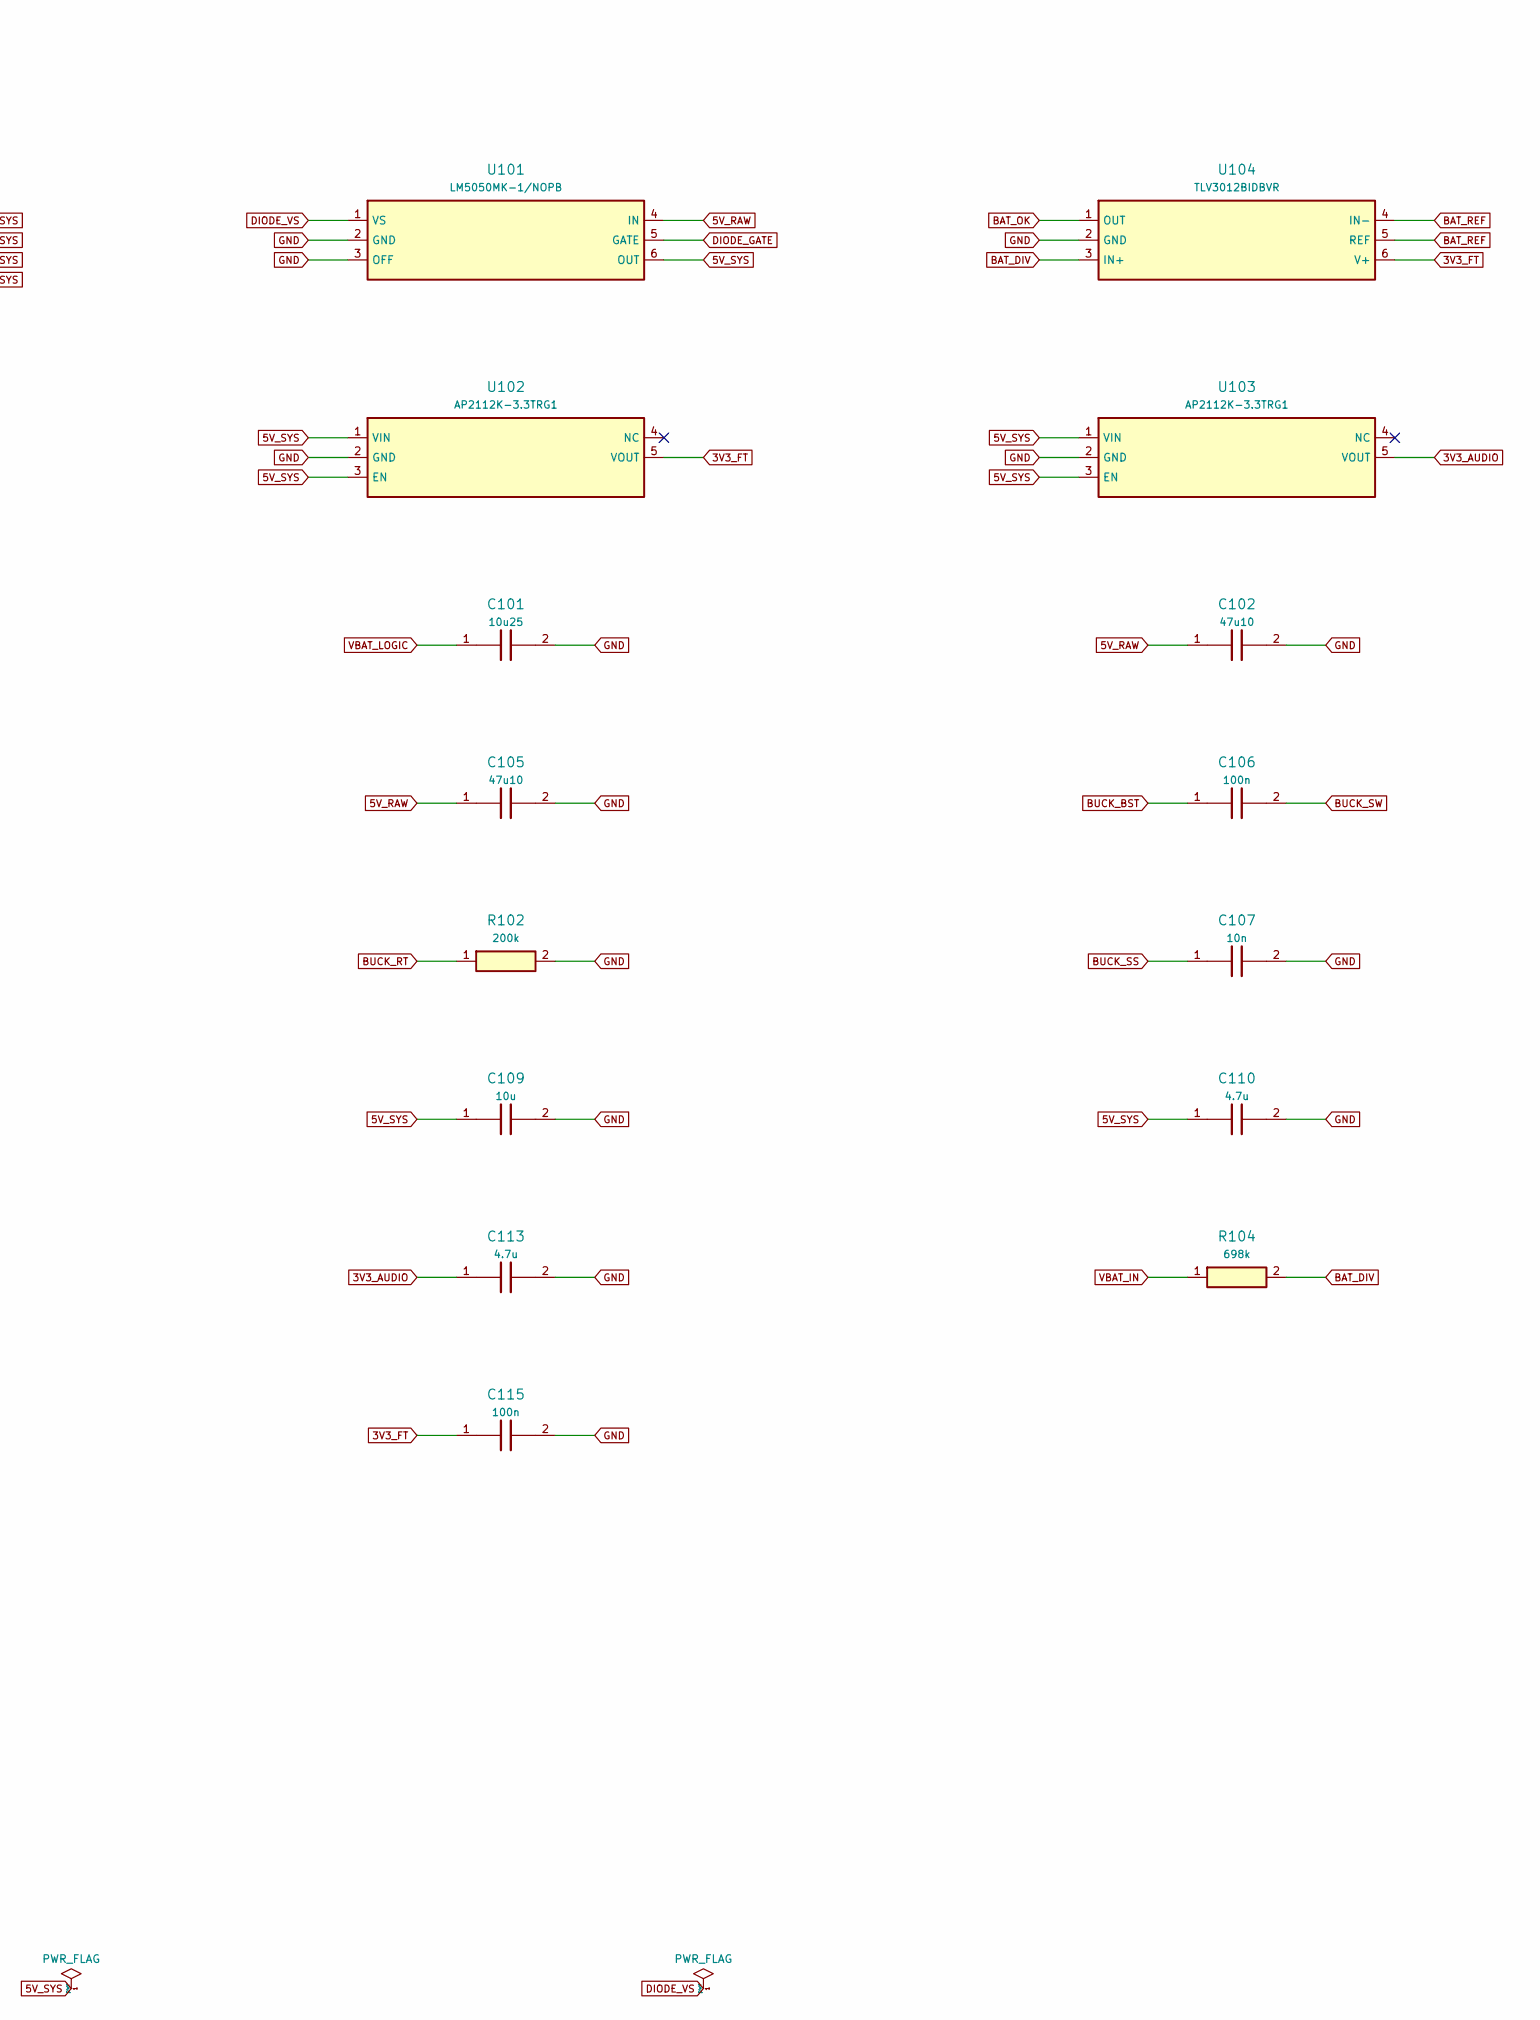
[picture p20: schematic 01_Power.kicad_sch, 01_Power | HEAD B2 / 65x30mm / 6L, part in row 1, column 2]

Parts:
C100, C101: 10u25; Capacitor_SMD__C_1206_3216Metric; MPN GRM31CR71E106KA12L
C102, C103, C104, C105: 47u10; Capacitor_SMD__C_1210_3225Metric; MPN GRM32ER71A476KE15L
C106, C115: 100n; Capacitor_SMD__C_0402_1005Metric; MPN GRM155R71C104KA88D
C107, C114: 10n; Capacitor_SMD__C_0402_1005Metric; MPN GRM155R71H103KA88D
C108: 100n; Capacitor_SMD__C_0402_1005Metric; MPN GRM155R71H104KE14D
C109: 10u; Capacitor_SMD__C_0603_1608Metric; MPN GRM188R61A106KE69D
C110, C111, C112, C113: 4.7u; Capacitor_SMD__C_0603_1608Metric; MPN GRM188R60J475KE19D
F100: 3A logic fuse; Fuse__Fuse_1206_3216Metric; MPN 0467003.NR
J100: 3S BAT IN; Connector_Molex__Molex_Nano-Fit_105313-xx02_1x02_P2.50mm_Ho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; MPN 1053131202
L100: 6.8uH; Inductor_SMD__L_Coilcraft_XAL6060-XXX; MPN XAL6060-682MEC
Q100: AOSP36326C; Package_SO__SOIC-8_3.9x4.9mm_P1.27mm; MPN AOSP36326C
R100: 52.3k; Resistor_SMD__R_0402_1005Metric; MPN RC0402FR-0752K3L
R101: 10k; Resistor_SMD__R_0402_1005Metric; MPN RC0402FR-0710KL
R102: 200k; Resistor_SMD__R_0402_1005Metric; MPN RC0402FR-07200KL
R103: 100R; Resistor_SMD__R_0402_1005Metric; MPN RC0402FR-07100RL
R104: 698k; Resistor_SMD__R_0402_1005Metric; MPN RC0402FR-07698KL
R105: 100k; Resistor_SMD__R_0402_1005Metric; MPN RC0402FR-07100KL
U100: AP64502SP-13; AP64502_SO8EP; MPN AP64502SP-13
U101: LM5050MK-1/NOPB; Package_TO_SOT_SMD__SOT-23-6; MPN LM5050MK-1/NOPB
U102, U103: AP2112K-3.3TRG1; Package_TO_SOT_SMD__SOT-23-5; MPN AP2112K-3.3TRG1
U104: TLV3012BIDBVR; Package_TO_SOT_SMD__SOT-23-6; MPN TLV3012BIDBVR

Connections:
3V3_AUDIO: C113.1, U103.5 (VOUT); also elsewhere on the board
3V3_FT: C111.1, C115.1, U102.5 (VOUT), U104.6 (V+); also elsewhere on the board
5V_RAW: C102.1, C103.1, C104.1, C105.1, L100.2, Q100.1, Q100.2, Q100.3, R100.1, U101.4 (IN)
5V_SYS: C109.1, C110.1, C112.1, Q100.5, Q100.6, Q100.7, Q100.8, U101.6 (OUT), U102.1 (VIN), U102.3 (EN), U103.1 (VIN), U103.3 (EN); also elsewhere on the board
BAT_DIV: C114.1, R104.2, R105.1, U104.3 (IN+)
BAT_OK: U104.1 (OUT); also elsewhere on the board
BAT_REF: U104.4 (IN-), U104.5 (REF)
BUCK_BST: C106.1, U100.1 (BST)
BUCK_FB: R100.2, R101.1, U100.5 (FB)
BUCK_RT: R102.1, U100.4 (RT_CLK)
BUCK_SS: C107.1, U100.6 (SS)
BUCK_SW: C106.2, L100.1, U100.8 (SW)
DIODE_GATE: Q100.4, U101.5 (GATE)
DIODE_VS: C108.1, R103.2, U101.1 (VS)
GND: C100.2, C101.2, C102.2, C103.2, C104.2, C105.2, C107.2, C108.2, C109.2, C110.2, C111.2, C112.2, C113.2, C114.2, C115.2, J100.2, R101.2, R102.2, R105.2, U100.7 (GND), U100.9 (EP_GND), U101.2 (GND), U101.3 (OFF), U102.2 (GND), U103.2 (GND), U104.2 (GND); also elsewhere on the board
VBAT_IN: F100.1, J100.1, R104.1; also elsewhere on the board
VBAT_LOGIC: C100.1, C101.1, F100.2, R103.1, U100.2 (VIN), U100.3 (EN)

Notes on the sheet:
Matching global net labels connect across sheets. Unused pins are marked NC.
Ground is common; servo +3S is separate from logic +5V. See README for unresolved electrical and mechanical checks.

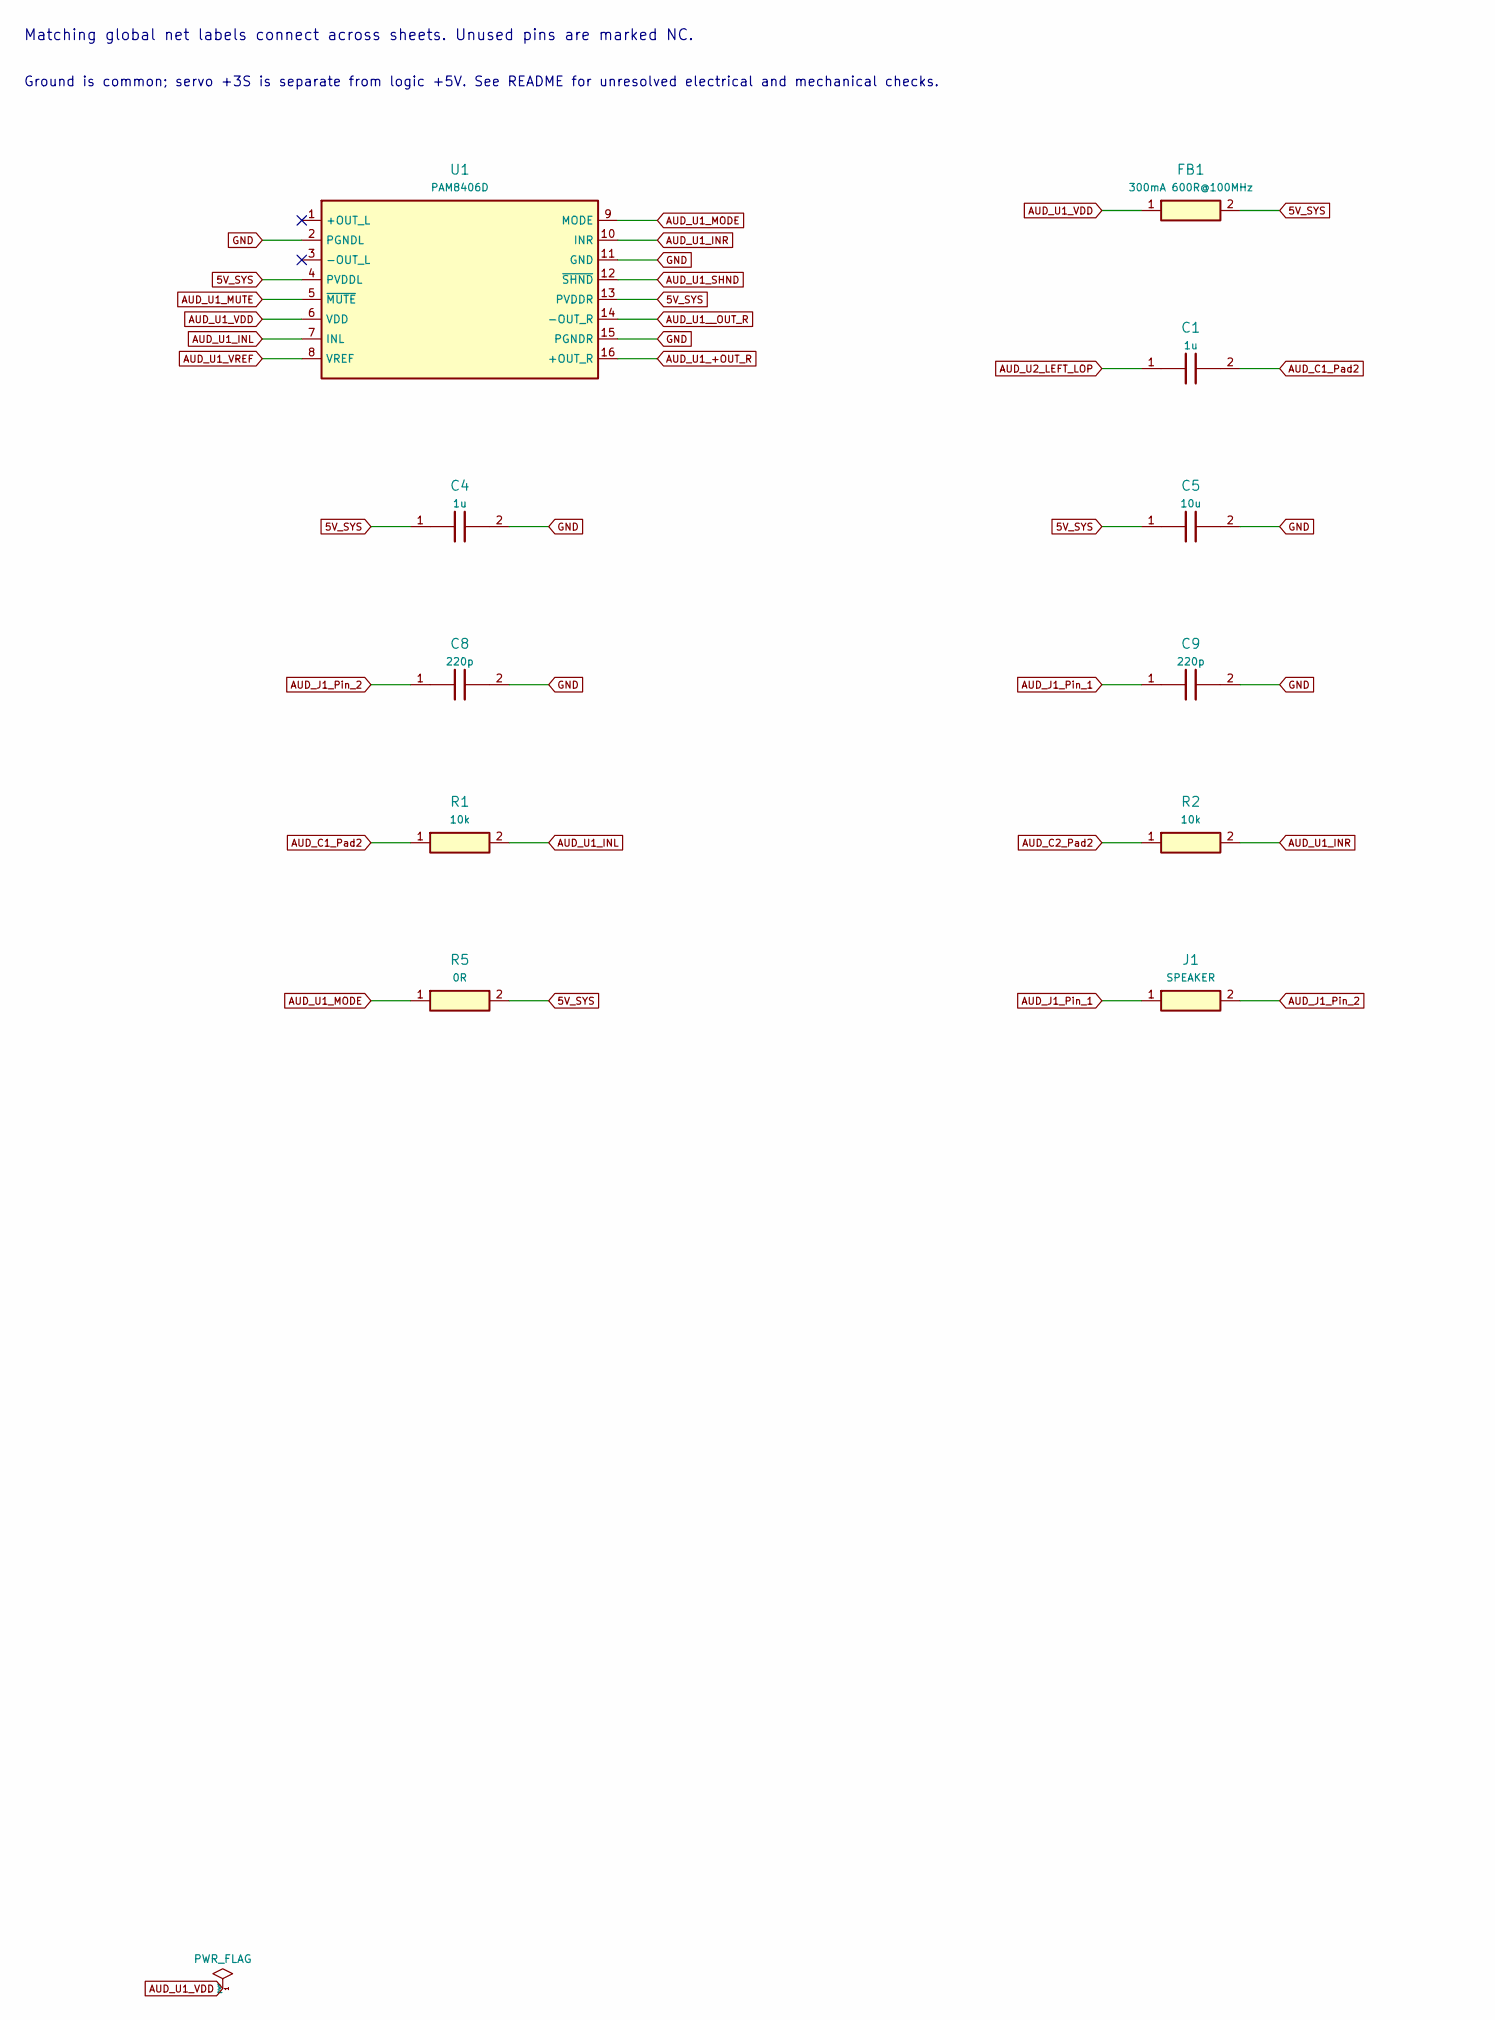
[picture p21: schematic 02_Audio_Amplifier.kicad_sch, 02_Audio_Amplifier | HEAD B2 / 65x30mm / 6L, part in row 1, column 1]

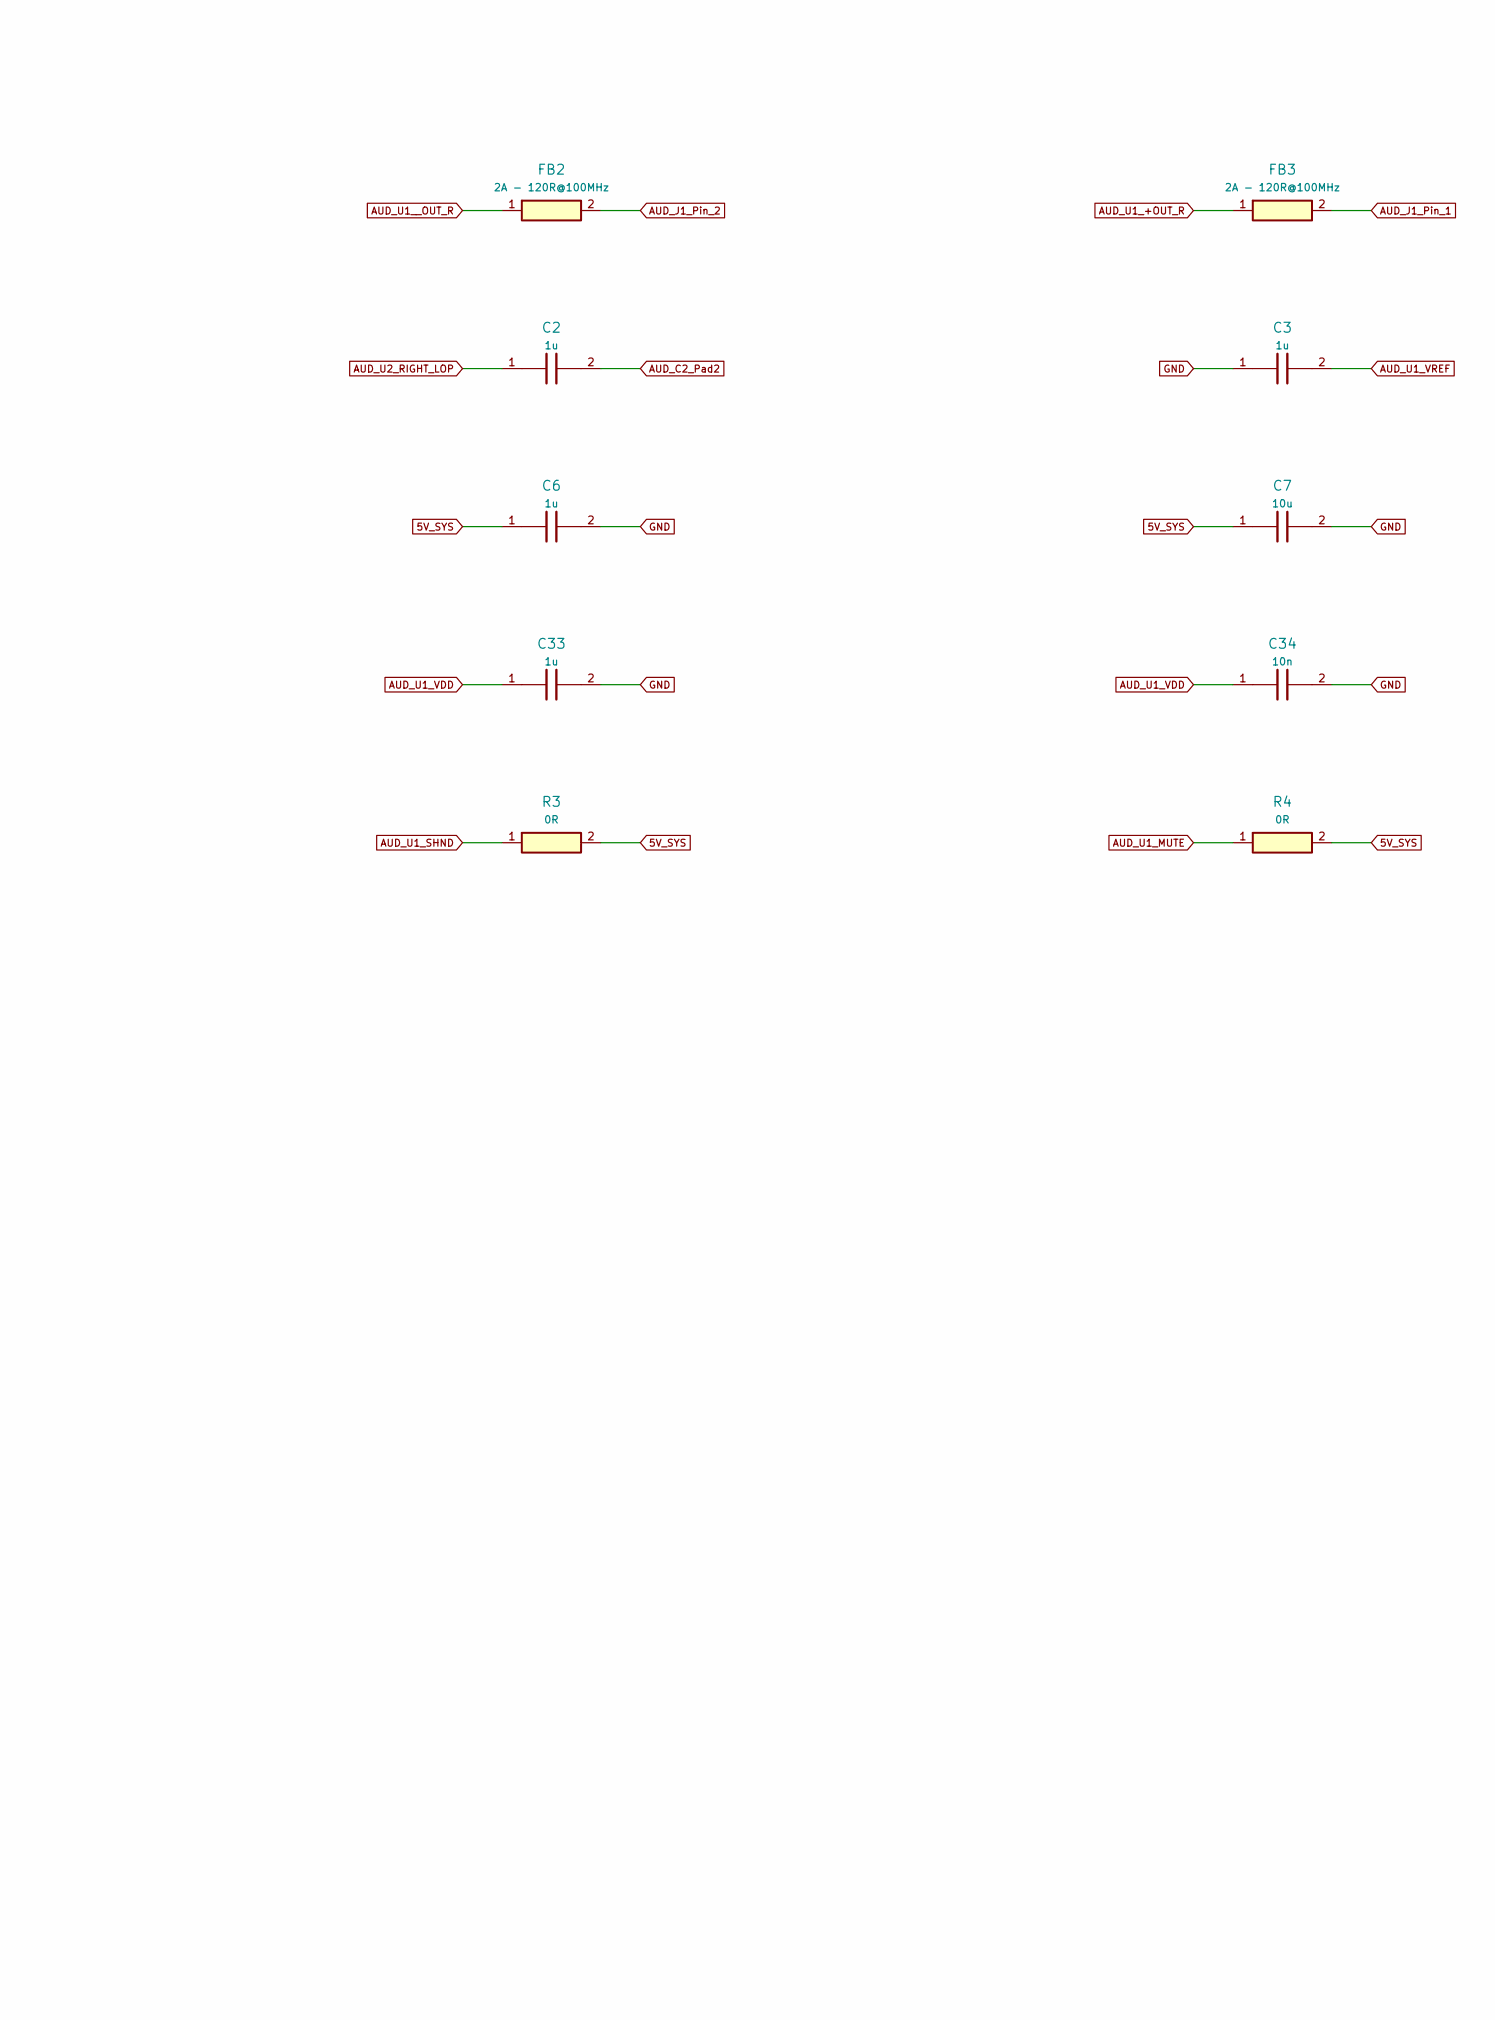
[picture p22: schematic 02_Audio_Amplifier.kicad_sch, 02_Audio_Amplifier | HEAD B2 / 65x30mm / 6L, part in row 1, column 2]

Parts:
C1, C2, C3, C4, C6, C33: 1u; Capacitor_SMD__C_0402_1005Metric; MPN GRM155R61A105KE15D
C5, C7: 10u; Capacitor_SMD__C_0603_1608Metric; MPN GRM188R61A106KE69D
C8, C9: 220p; Capacitor_SMD__C_0603_1608Metric; MPN GRM1885C1H221JA01D
C34: 10n; Capacitor_SMD__C_0402_1005Metric; MPN GRM155R71H103KA88D
FB1: 300mA 600R@100MHz; Pollen_FB1; MPN BLM15AG601SN1D
FB2: 2A - 120R@100MHz; Pollen_FB2; MPN BLM15PX121SN1D
FB3: 2A - 120R@100MHz; Pollen_FB3; MPN BLM15PX121SN1D
J1: SPEAKER; Connector_JST__JST_PH_B2B-PH-K_1x02_P2.00mm_Vertical; MPN B2B-PH-K-S
R1, R2: 10k; Resistor_SMD__R_0402_1005Metric; MPN RC0402FR-0710KL
R3, R4, R5: 0R; Resistor_SMD__R_0402_1005Metric; MPN RC0402JR-070RL
U1: PAM8406D; Pollen_U1; MPN PAM8406DR

Connections:
5V_SYS: C4.1, C5.1, C6.1, C7.1, FB1.2, R3.2, R4.2, R5.2, U1.4 (PVDDL), U1.13 (PVDDR); also elsewhere on the board
AUD_C1_Pad2: C1.2, R1.1
AUD_C2_Pad2: C2.2, R2.1
AUD_J1_Pin_1: C9.1, FB3.2, J1.1
AUD_J1_Pin_2: C8.1, FB2.2, J1.2
AUD_U1_+OUT_R: FB3.1, U1.16 (+OUT_R)
AUD_U1_INL: R1.2, U1.7 (INL)
AUD_U1_INR: R2.2, U1.10 (INR)
AUD_U1_MODE: R5.1, U1.9 (MODE)
AUD_U1_MUTE: R4.1, U1.5 (~MUTE)
AUD_U1_SHND: R3.1, U1.12 (~SHND)
AUD_U1_VDD: C33.1, C34.1, FB1.1, U1.6 (VDD)
AUD_U1_VREF: C3.2, U1.8 (VREF)
AUD_U1__OUT_R: FB2.1, U1.14 (-OUT_R)
AUD_U2_LEFT_LOP: C1.1; also elsewhere on the board
AUD_U2_RIGHT_LOP: C2.1; also elsewhere on the board
GND: C3.1, C4.2, C5.2, C6.2, C7.2, C8.2, C9.2, C33.2, C34.2, U1.2 (PGNDL), U1.11 (GND), U1.15 (PGNDR); also elsewhere on the board

Notes on the sheet:
Matching global net labels connect across sheets. Unused pins are marked NC.
Ground is common; servo +3S is separate from logic +5V. See README for unresolved electrical and mechanical checks.

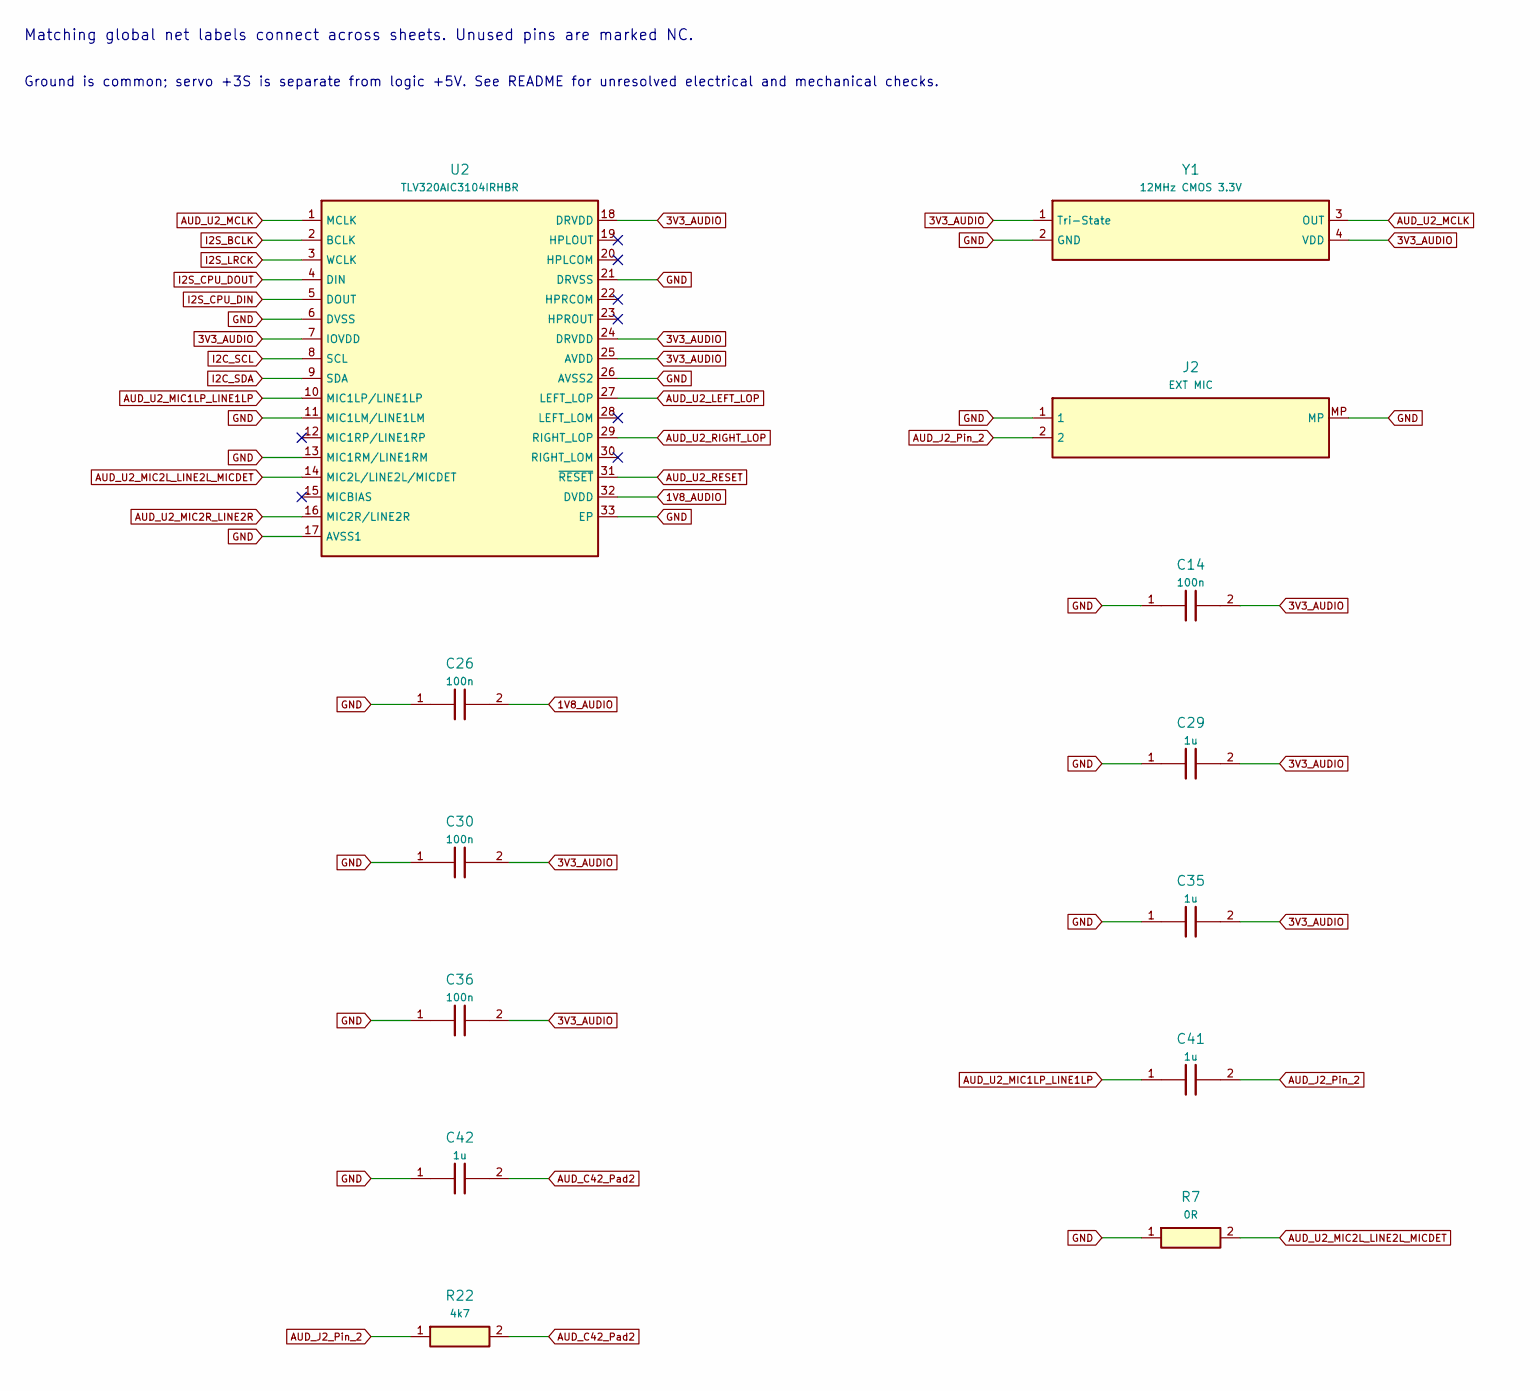
[picture p23: schematic 02_Audio_Codec.kicad_sch, 02_Audio_Codec | HEAD B2 / 65x30mm / 6L, part in row 1, column 1]

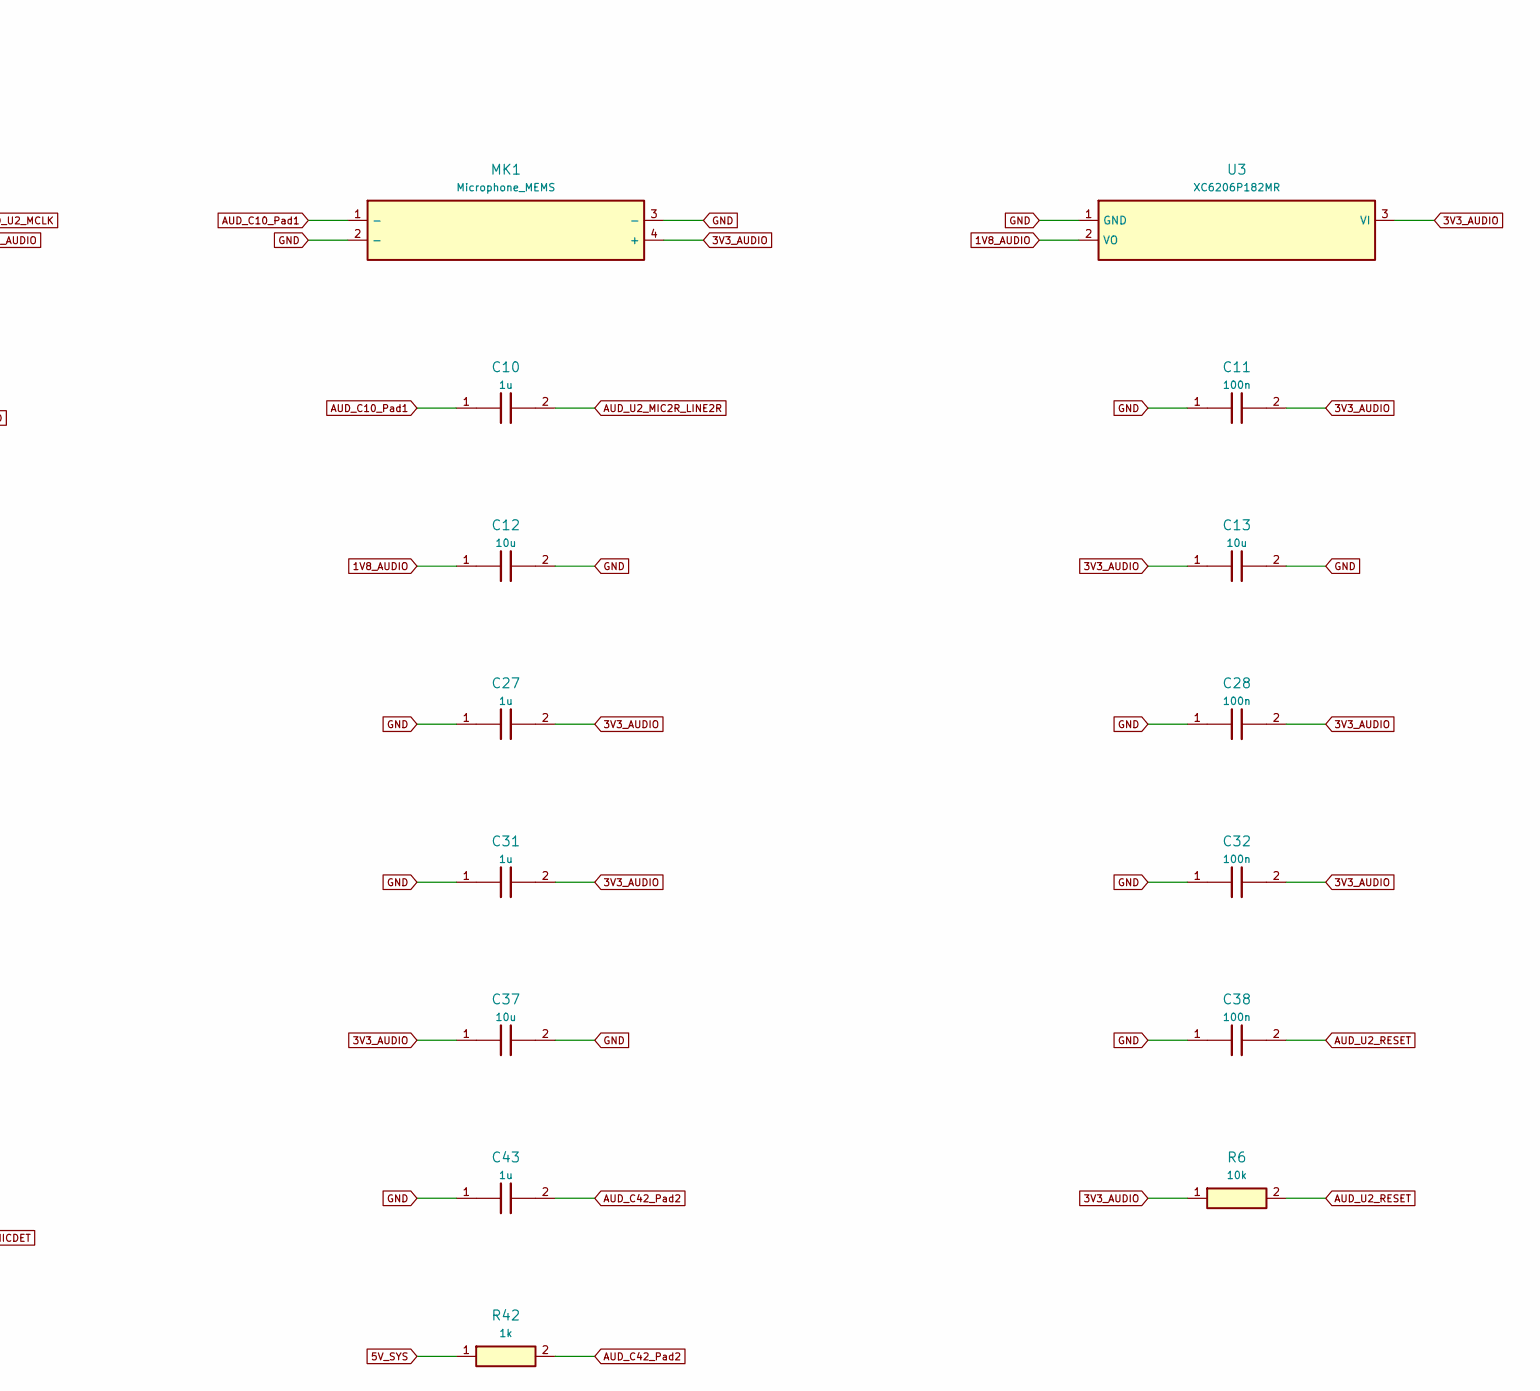
[picture p24: schematic 02_Audio_Codec.kicad_sch, 02_Audio_Codec | HEAD B2 / 65x30mm / 6L, part in row 1, column 2]

Parts:
C10, C27, C29, C31, C35, C41, C42, C43: 1u; Capacitor_SMD__C_0402_1005Metric; MPN GRM155R61A105KE15D
C11, C14, C26, C28, C30, C32, C36, C38: 100n; Capacitor_SMD__C_0402_1005Metric; MPN GRM155R71C104KA88D
C12, C13, C37: 10u; Capacitor_SMD__C_0603_1608Metric; MPN GRM188R61A106KE69D
J2: EXT MIC; Connector_JST__JST_SH_BM02B-SRSS-TB_1x02-1MP_P1.00mm_Vertic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; MPN BM02B-SRSS-TB(LF)(SN)
MK1: Microphone_MEMS; Pollen_MK1; MPN LMA2718T421-OA5-2
R6: 10k; Resistor_SMD__R_0402_1005Metric; MPN RC0402FR-0710KL
R7: 0R; Resistor_SMD__R_0402_1005Metric; MPN RC0402JR-070RL
R22: 4k7; Resistor_SMD__R_0402_1005Metric; MPN RC0402FR-074K7L
R42: 1k; Resistor_SMD__R_0402_1005Metric; MPN RC0402FR-071KL
U2: TLV320AIC3104IRHBR; Pollen_U2; MPN TLV320AIC3104IRHBR
U3: XC6206P182MR; Pollen_U3; MPN XC6206P182MR-G
Y1: 12MHz CMOS 3.3V; Pollen_Y1; MPN ASDMB-12.000MHZ-LC-T

Connections:
1V8_AUDIO: C12.1, C26.2, U2.32 (DVDD), U3.2 (VO)
3V3_AUDIO: C11.2, C13.1, C14.2, C27.2, C28.2, C29.2, C30.2, C31.2, C32.2, C35.2, C36.2, C37.1, MK1.4 (+), R6.1, U2.7 (IOVDD), U2.18 (DRVDD), U2.24 (DRVDD), U2.25 (AVDD), U3.3 (VI), Y1.1 (Tri-State), Y1.4 (VDD); also elsewhere on the board
5V_SYS: R42.1; also elsewhere on the board
AUD_C10_Pad1: C10.1, MK1.1 (-)
AUD_C42_Pad2: C42.2, C43.2, R22.2, R42.2
AUD_J2_Pin_2: C41.2, J2.2, R22.1
AUD_U2_LEFT_LOP: U2.27 (LEFT_LOP); also elsewhere on the board
AUD_U2_MCLK: U2.1 (MCLK), Y1.3 (OUT)
AUD_U2_MIC1LP_LINE1LP: C41.1, U2.10 (MIC1LP/LINE1LP)
AUD_U2_MIC2L_LINE2L_MICDET: R7.2, U2.14 (MIC2L/LINE2L/MICDET)
AUD_U2_MIC2R_LINE2R: C10.2, U2.16 (MIC2R/LINE2R)
AUD_U2_RESET: C38.2, R6.2, U2.31 (~RESET)
AUD_U2_RIGHT_LOP: U2.29 (RIGHT_LOP); also elsewhere on the board
GND: C11.1, C12.2, C13.2, C14.1, C26.1, C27.1, C28.1, C29.1, C30.1, C31.1, C32.1, C35.1, C36.1, C37.2, C38.1, C42.1, C43.1, J2.1, J2.MP, MK1.2 (-), MK1.3 (-), R7.1, U2.6 (DVSS), U2.11 (MIC1LM/LINE1LM), U2.13 (MIC1RM/LINE1RM), U2.17 (AVSS1), U2.21 (DRVSS), U2.26 (AVSS2), U2.33 (EP), U3.1 (GND), Y1.2 (GND); also elsewhere on the board
I2C_SCL: U2.8 (SCL); also elsewhere on the board
I2C_SDA: U2.9 (SDA); also elsewhere on the board
I2S_BCLK: U2.2 (BCLK); also elsewhere on the board
I2S_CPU_DIN: U2.5 (DOUT); also elsewhere on the board
I2S_CPU_DOUT: U2.4 (DIN); also elsewhere on the board
I2S_LRCK: U2.3 (WCLK); also elsewhere on the board

Notes on the sheet:
Matching global net labels connect across sheets. Unused pins are marked NC.
Ground is common; servo +3S is separate from logic +5V. See README for unresolved electrical and mechanical checks.
