eugenewang5425/MicroDinosaur/hardware/head_hat/kicad/HEAD_A0.kicad_pcb

## KiCad design hardware/head_hat/kicad/HEAD_A0.kicad_pcb (continued)

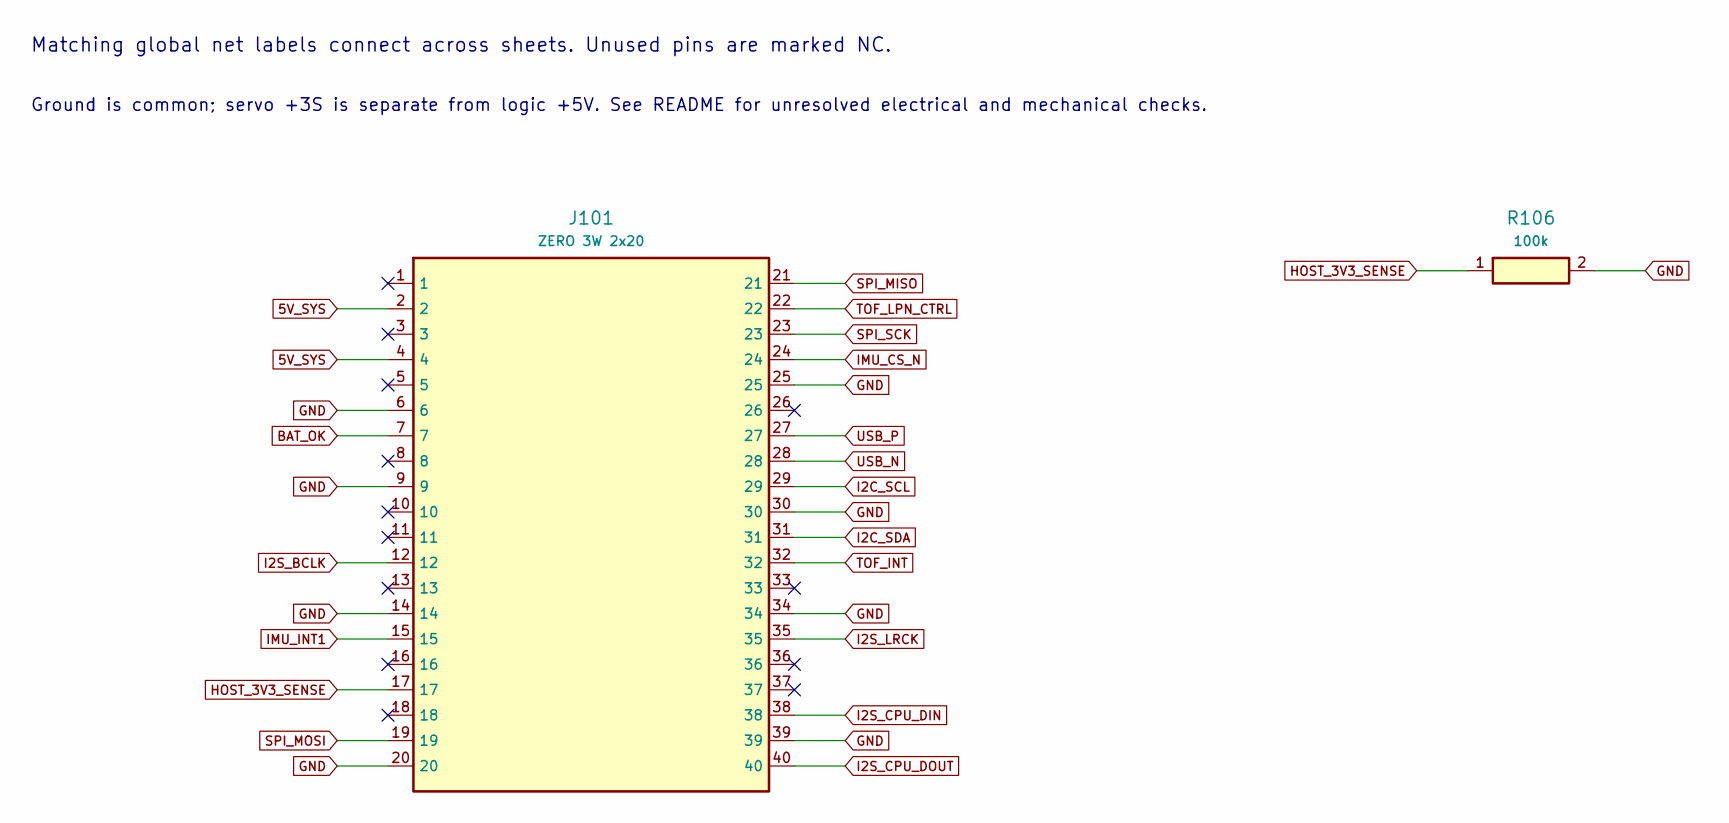
[picture p25: schematic 03_HOST.kicad_sch, 03_HOST | HEAD B2 / 65x30mm / 6L]

Parts:
J101: ZERO 3W 2x20; Connector_PinHeader_2.54mm__PinHeader_2x20_P2.54mm_Vertical; MPN 61304021121
R106: 100k; Resistor_SMD__R_0402_1005Metric; MPN RC0402FR-07100KL

Connections:
5V_SYS: J101.2, J101.4; also elsewhere on the board
BAT_OK: J101.7; also elsewhere on the board
GND: J101.6, J101.9, J101.14, J101.20, J101.25, J101.30, J101.34, J101.39, R106.2; also elsewhere on the board
HOST_3V3_SENSE: J101.17, R106.1; also elsewhere on the board
I2C_SCL: J101.29; also elsewhere on the board
I2C_SDA: J101.31; also elsewhere on the board
I2S_BCLK: J101.12; also elsewhere on the board
I2S_CPU_DIN: J101.38; also elsewhere on the board
I2S_CPU_DOUT: J101.40; also elsewhere on the board
I2S_LRCK: J101.35; also elsewhere on the board
IMU_CS_N: J101.24; also elsewhere on the board
IMU_INT1: J101.15; also elsewhere on the board
SPI_MISO: J101.21; also elsewhere on the board
SPI_MOSI: J101.19; also elsewhere on the board
SPI_SCK: J101.23; also elsewhere on the board
TOF_INT: J101.32; also elsewhere on the board
TOF_LPN_CTRL: J101.22; also elsewhere on the board
USB_N: J101.28; also elsewhere on the board
USB_P: J101.27; also elsewhere on the board

Notes on the sheet:
Matching global net labels connect across sheets. Unused pins are marked NC.
Ground is common; servo +3S is separate from logic +5V. See README for unresolved electrical and mechanical checks.

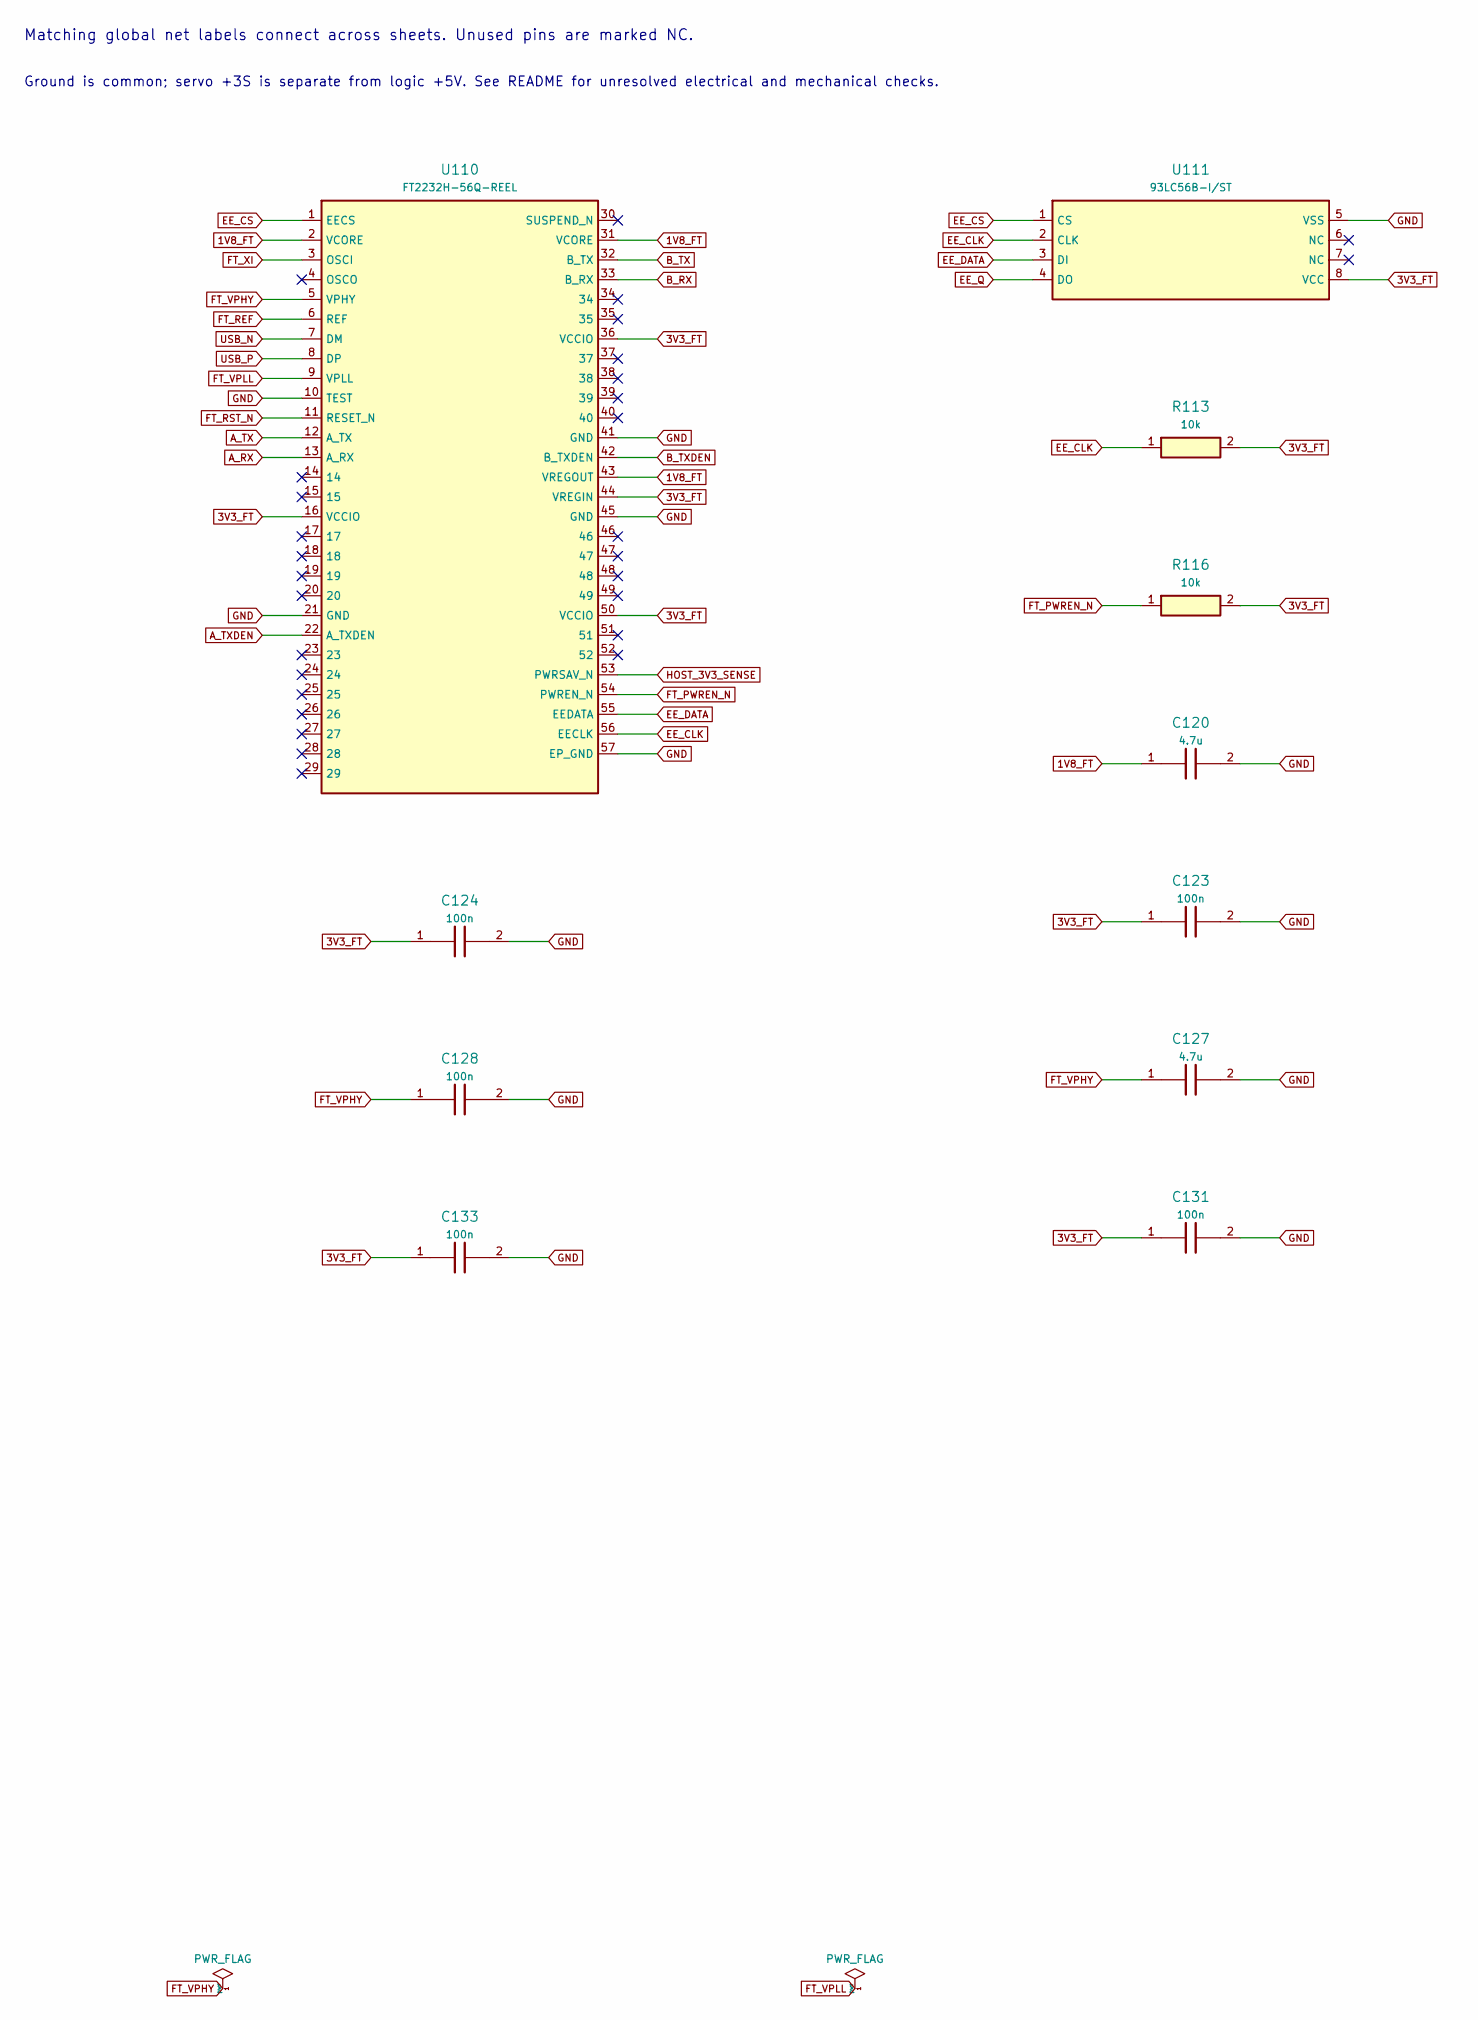
[picture p26: schematic 04_USB_UART.kicad_sch, 04_USB_UART | HEAD B2 / 65x30mm / 6L, part in row 1, column 1]

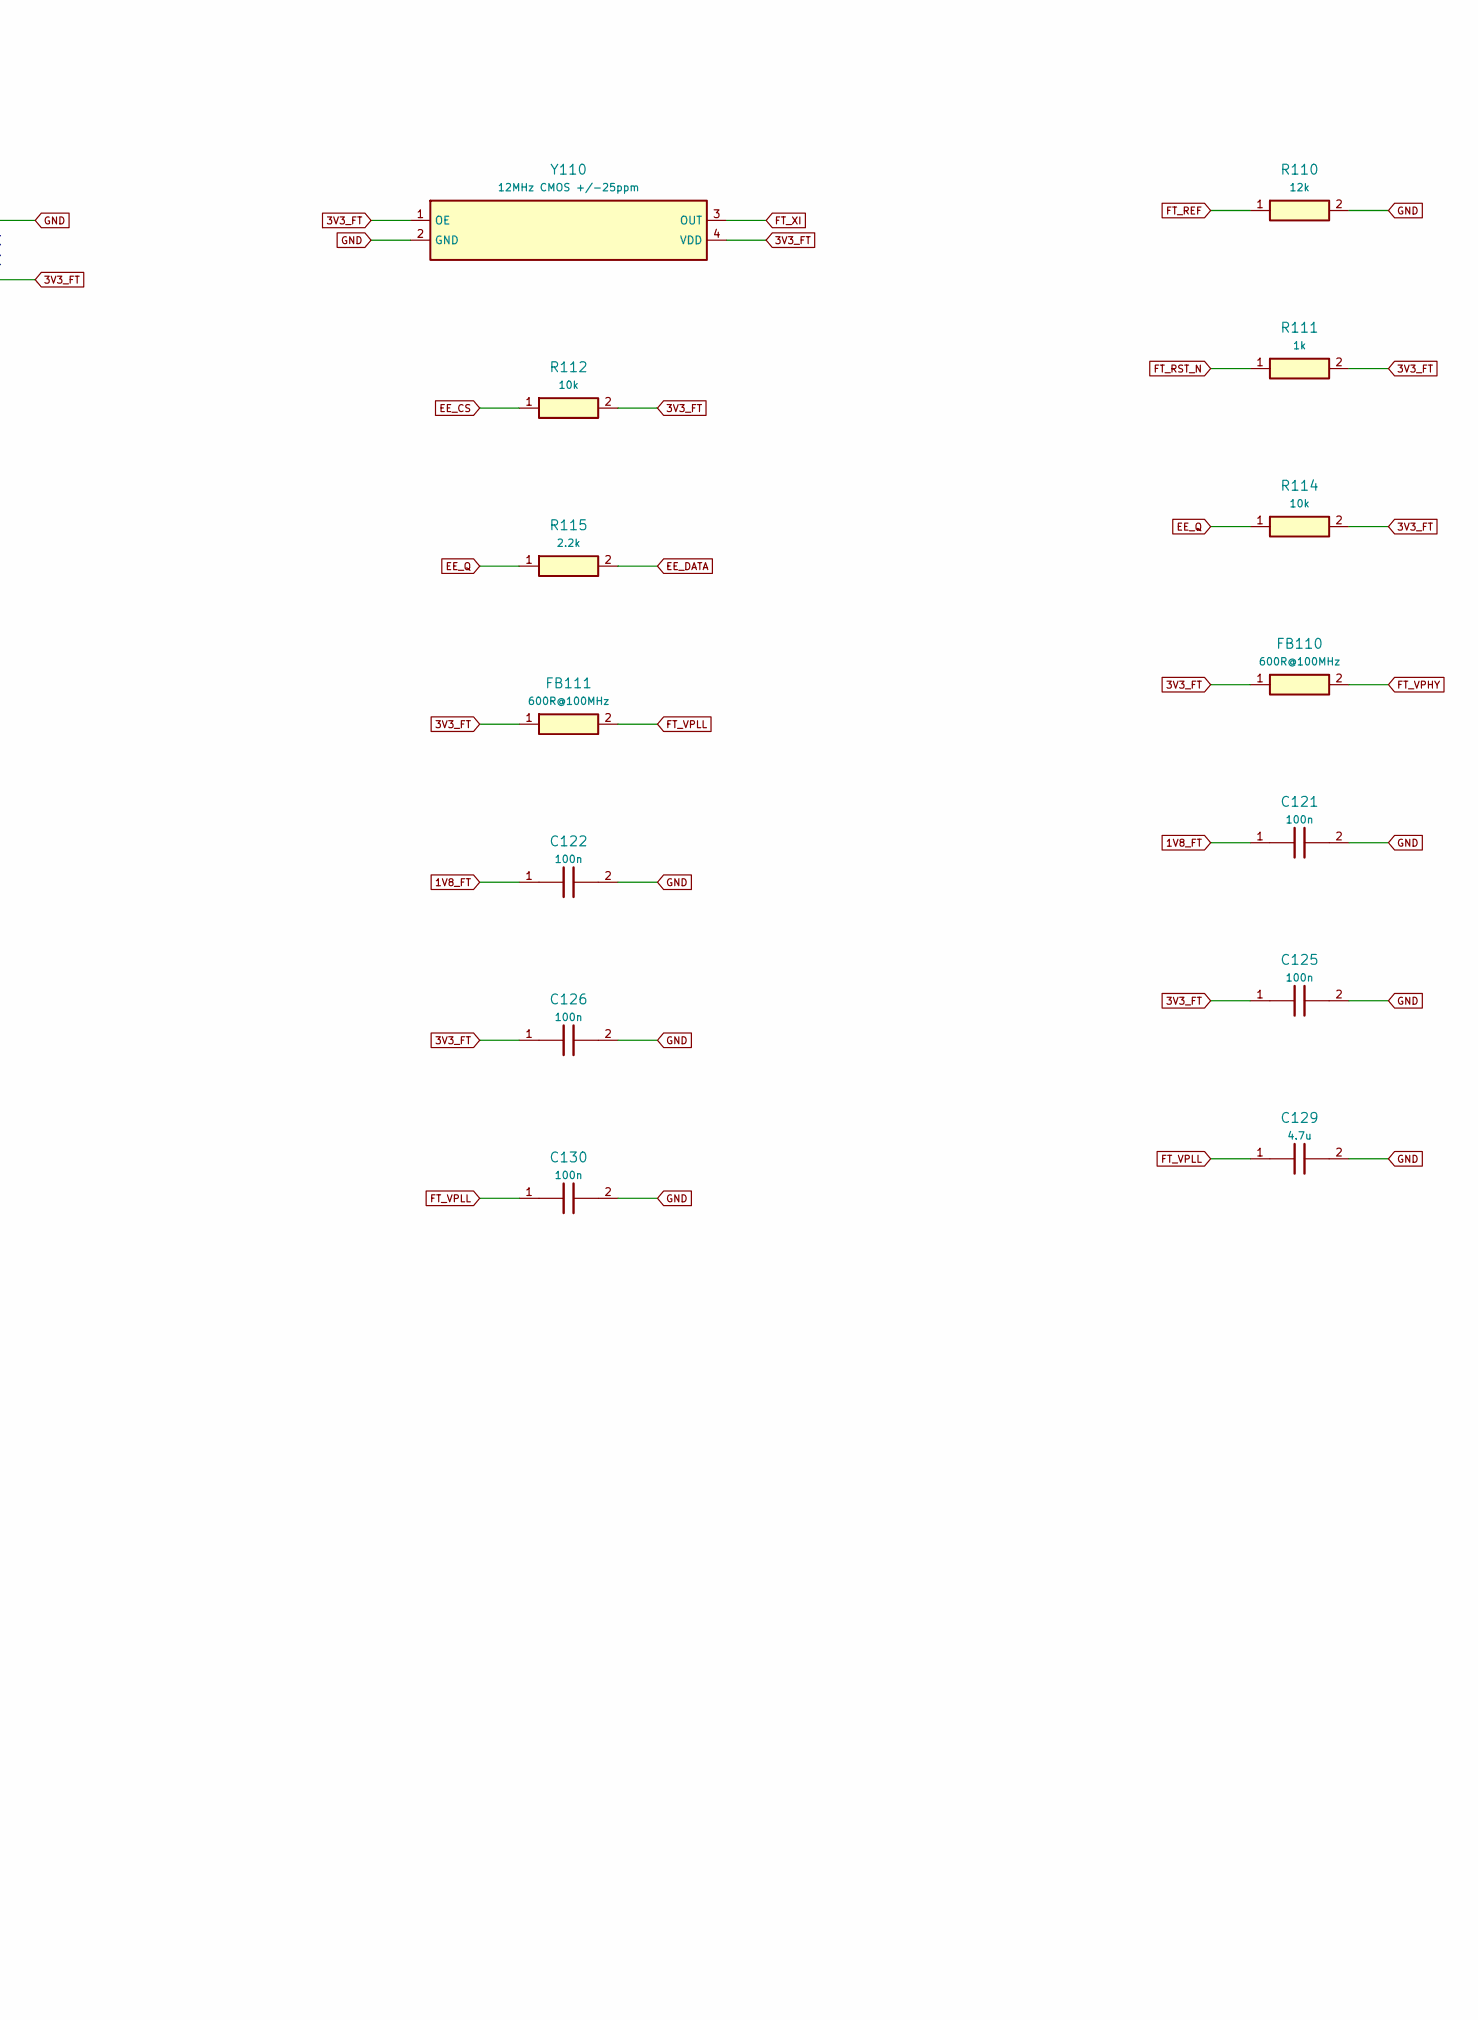
[picture p27: schematic 04_USB_UART.kicad_sch, 04_USB_UART | HEAD B2 / 65x30mm / 6L, part in row 1, column 2]

Parts:
C120, C127, C129: 4.7u; Capacitor_SMD__C_0603_1608Metric; MPN GRM188R60J475KE19D
C121, C122, C123, C124, C125, C126, C128, C130, C131, C133: 100n; Capacitor_SMD__C_0402_1005Metric; MPN GRM155R71C104KA88D
FB110, FB111: 600R@100MHz; Resistor_SMD__R_0603_1608Metric; MPN BLM18AG601SN1D
R110: 12k; Resistor_SMD__R_0402_1005Metric; MPN RC0402FR-0712KL
R111: 1k; Resistor_SMD__R_0402_1005Metric; MPN RC0402FR-071KL
R112, R113, R114, R116: 10k; Resistor_SMD__R_0402_1005Metric; MPN RC0402FR-0710KL
R115: 2.2k; Resistor_SMD__R_0402_1005Metric; MPN RC0402FR-072K2L
U110: FT2232H-56Q-REEL; Package_DFN_QFN__QFN-56-1EP_8x8mm_P0.5mm_EP5.9x5.9mm; MPN FT2232H-56Q-REEL
U111: 93LC56B-I/ST; Package_SO__TSSOP-8_3x3mm_P0.65mm; MPN 93LC56B-I/ST
Y110: 12MHz CMOS +/-25ppm; SiTime_2520_Oscillator; MPN SiT1602BI-12-33E-12.000000E

Connections:
1V8_FT: C120.1, C121.1, C122.1, U110.2 (VCORE), U110.31 (VCORE), U110.43 (VREGOUT)
3V3_FT: C123.1, C124.1, C125.1, C126.1, C131.1, C133.1, FB110.1, FB111.1, R111.2, R112.2, R113.2, R114.2, R116.2, U110.16 (VCCIO), U110.36 (VCCIO), U110.44 (VREGIN), U110.50 (VCCIO), U111.8 (VCC), Y110.1 (OE), Y110.4 (VDD); also elsewhere on the board
A_RX: U110.13 (A_RX); also elsewhere on the board
A_TX: U110.12 (A_TX); also elsewhere on the board
A_TXDEN: U110.22 (A_TXDEN); also elsewhere on the board
B_RX: U110.33 (B_RX); also elsewhere on the board
B_TX: U110.32 (B_TX); also elsewhere on the board
B_TXDEN: U110.42 (B_TXDEN); also elsewhere on the board
EE_CLK: R113.1, U110.56 (EECLK), U111.2 (CLK)
EE_CS: R112.1, U110.1 (EECS), U111.1 (CS)
EE_DATA: R115.2, U110.55 (EEDATA), U111.3 (DI)
EE_Q: R114.1, R115.1, U111.4 (DO)
FT_PWREN_N: R116.1, U110.54 (PWREN_N); also elsewhere on the board
FT_REF: R110.1, U110.6 (REF)
FT_RST_N: R111.1, U110.11 (RESET_N)
FT_VPHY: C127.1, C128.1, FB110.2, U110.5 (VPHY)
FT_VPLL: C129.1, C130.1, FB111.2, U110.9 (VPLL)
FT_XI: U110.3 (OSCI), Y110.3 (OUT)
GND: C120.2, C121.2, C122.2, C123.2, C124.2, C125.2, C126.2, C127.2, C128.2, C129.2, C130.2, C131.2, C133.2, R110.2, U110.10 (TEST), U110.21 (GND), U110.41 (GND), U110.45 (GND), U110.57 (EP_GND), U111.5 (VSS), Y110.2 (GND); also elsewhere on the board
HOST_3V3_SENSE: U110.53 (PWRSAV_N); also elsewhere on the board
USB_N: U110.7 (DM); also elsewhere on the board
USB_P: U110.8 (DP); also elsewhere on the board

Notes on the sheet:
Matching global net labels connect across sheets. Unused pins are marked NC.
Ground is common; servo +3S is separate from logic +5V. See README for unresolved electrical and mechanical checks.

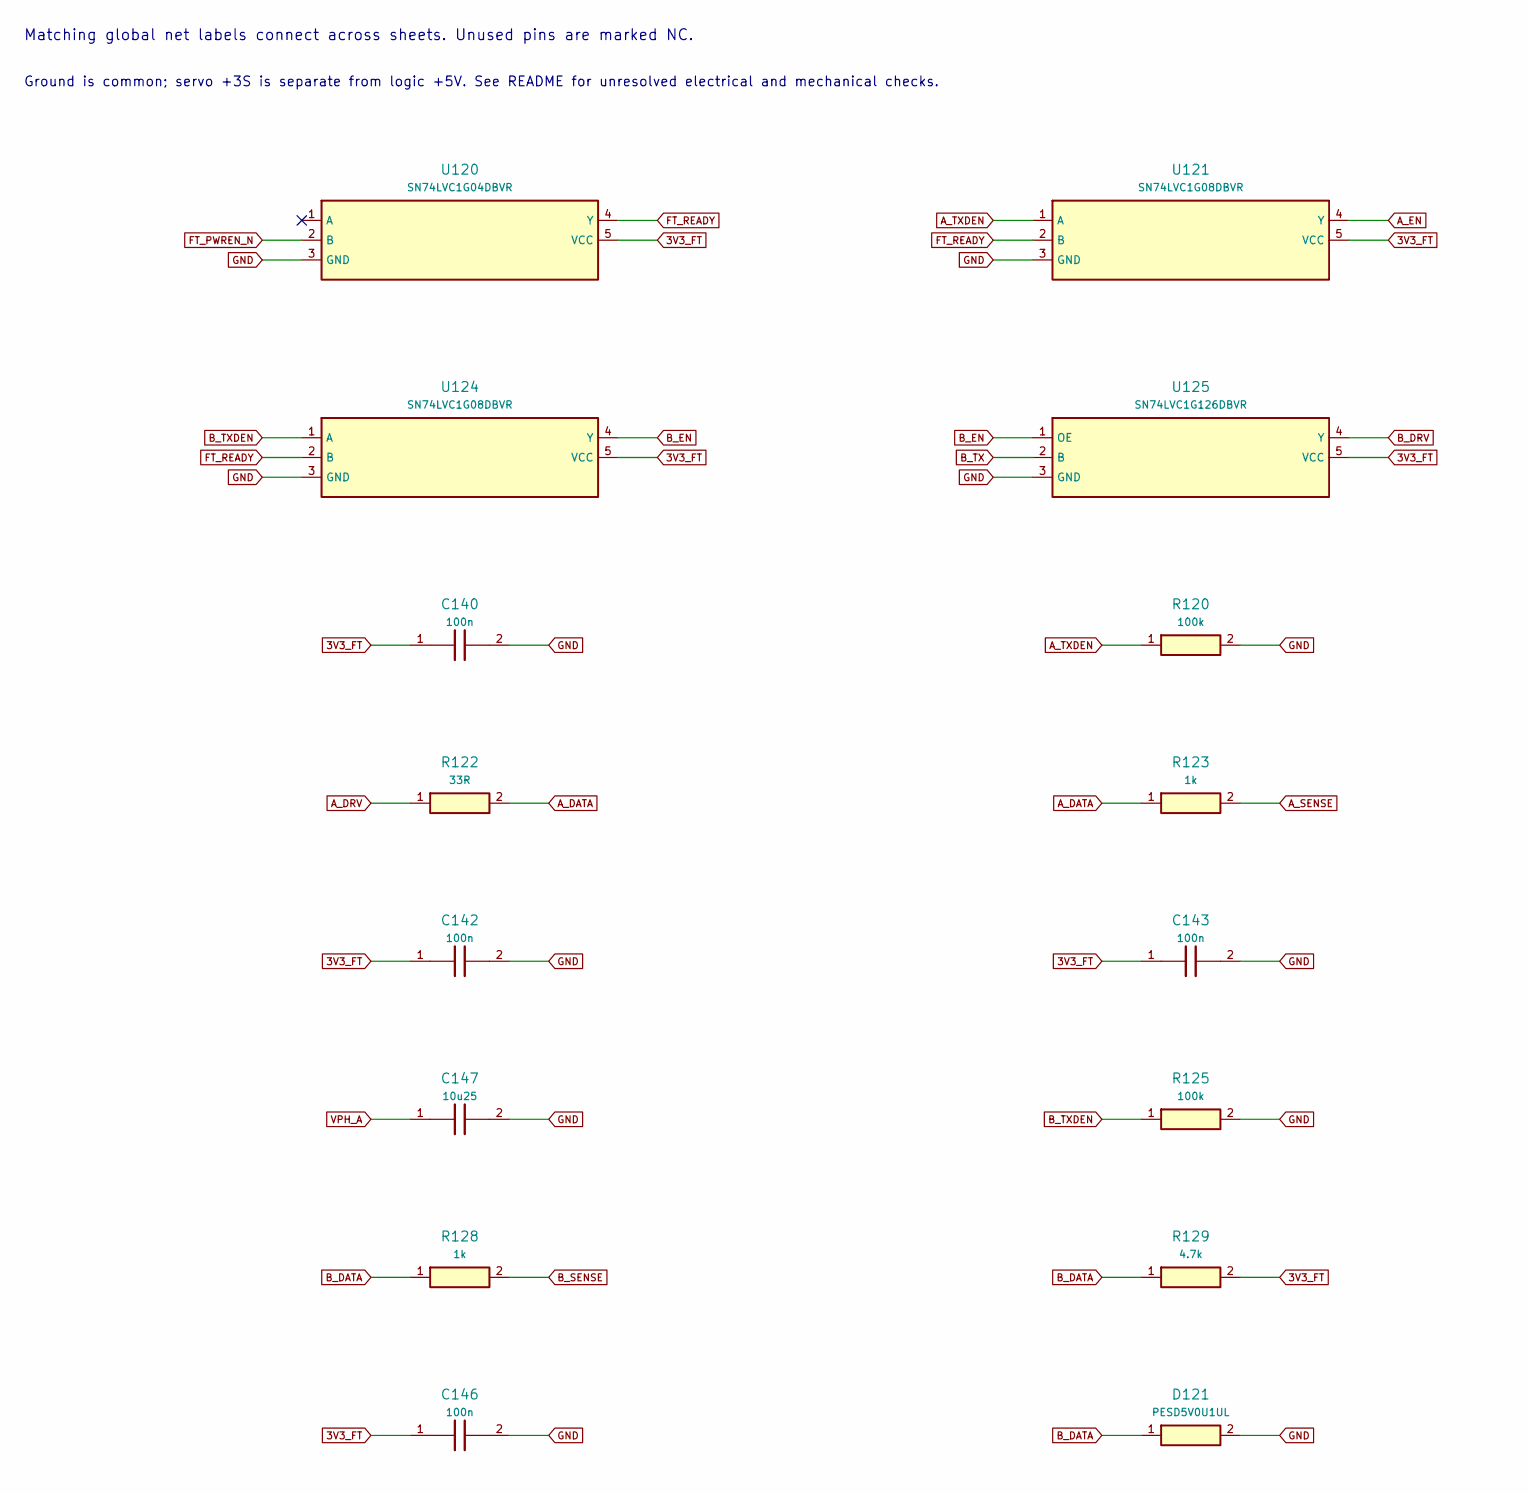
[picture p28: schematic 05_S288.kicad_sch, 05_S288 | HEAD B2 / 65x30mm / 6L, part in row 1, column 1]

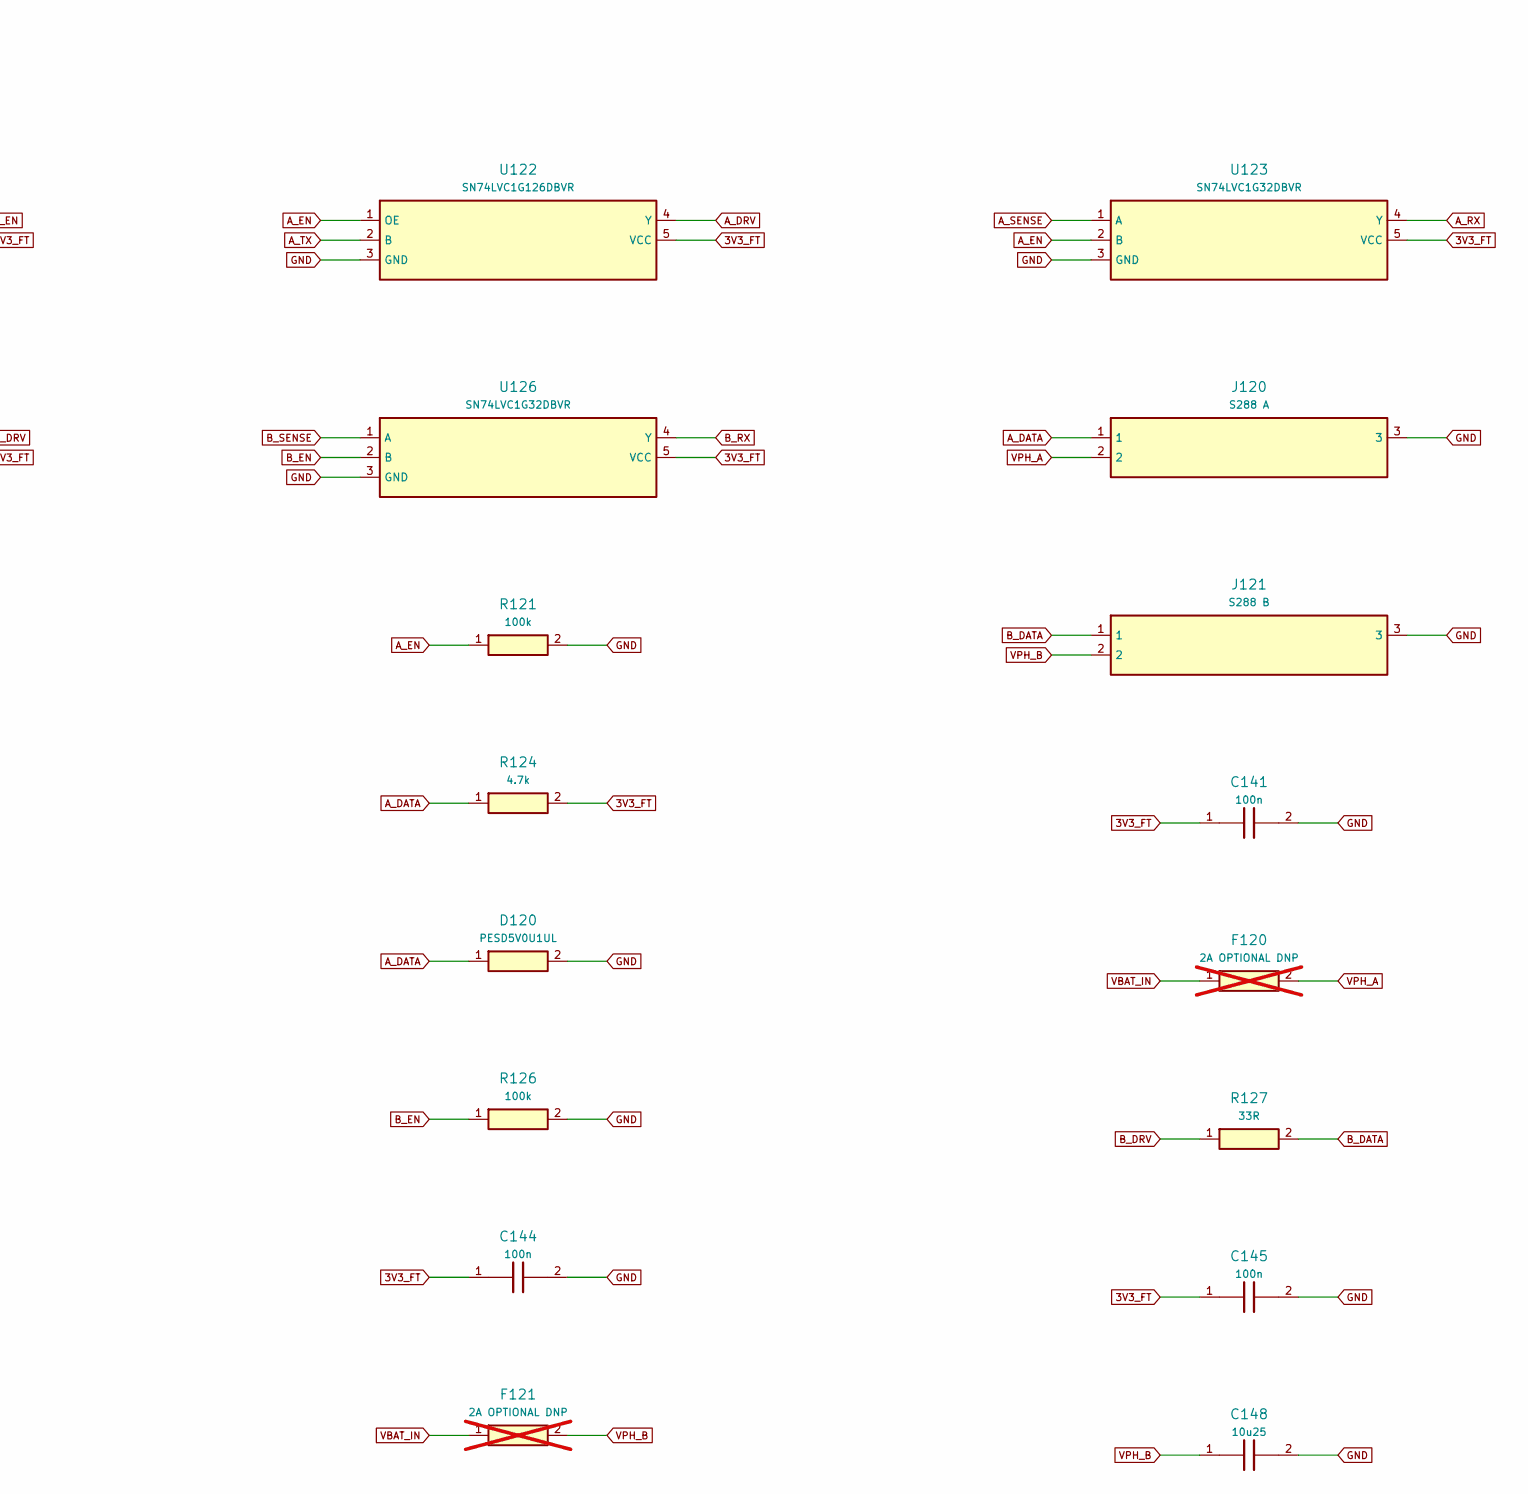
[picture p29: schematic 05_S288.kicad_sch, 05_S288 | HEAD B2 / 65x30mm / 6L, part in row 1, column 2]

Parts:
C140, C141, C142, C143, C144, C145, C146: 100n; Capacitor_SMD__C_0402_1005Metric; MPN GRM155R71C104KA88D
C147, C148: 10u25; Capacitor_SMD__C_1206_3216Metric; MPN GRM31CR71E106KA12L
D120, D121: PESD5V0U1UL; Diode_SMD__D_SOD-882; MPN PESD5V0U1UL,315
F120, F121: 2A OPTIONAL DNP; Fuse__Fuse_1206_3216Metric; MPN 0467002.NR; not fitted
J120: S288 A; Connector_JST__JST_PH_B3B-PH-K_1x03_P2.00mm_Vertical; MPN B3B-PH-K-S
J121: S288 B; Connector_JST__JST_PH_B3B-PH-K_1x03_P2.00mm_Vertical; MPN B3B-PH-K-S
R120, R121, R125, R126: 100k; Resistor_SMD__R_0402_1005Metric; MPN RC0402FR-07100KL
R122, R127: 33R; Resistor_SMD__R_0402_1005Metric; MPN RC0402FR-0733RL
R123, R128: 1k; Resistor_SMD__R_0402_1005Metric; MPN RC0402FR-071KL
R124, R129: 4.7k; Resistor_SMD__R_0402_1005Metric; MPN RC0402FR-074K7L
U120: SN74LVC1G04DBVR; Package_TO_SOT_SMD__SOT-23-5; MPN SN74LVC1G04DBVR
U121, U124: SN74LVC1G08DBVR; Package_TO_SOT_SMD__SOT-23-5; MPN SN74LVC1G08DBVR
U122, U125: SN74LVC1G126DBVR; Package_TO_SOT_SMD__SOT-23-5; MPN SN74LVC1G126DBVR
U123, U126: SN74LVC1G32DBVR; Package_TO_SOT_SMD__SOT-23-5; MPN SN74LVC1G32DBVR

Connections:
3V3_FT: C140.1, C141.1, C142.1, C143.1, C144.1, C145.1, C146.1, R124.2, R129.2, U120.5 (VCC), U121.5 (VCC), U122.5 (VCC), U123.5 (VCC), U124.5 (VCC), U125.5 (VCC), U126.5 (VCC); also elsewhere on the board
A_DATA: D120.1, J120.1, R122.2, R123.1, R124.1
A_DRV: R122.1, U122.4 (Y)
A_EN: R121.1, U121.4 (Y), U122.1 (OE), U123.2 (B)
A_RX: U123.4 (Y); also elsewhere on the board
A_SENSE: R123.2, U123.1 (A)
A_TX: U122.2 (B); also elsewhere on the board
A_TXDEN: R120.1, U121.1 (A); also elsewhere on the board
B_DATA: D121.1, J121.1, R127.2, R128.1, R129.1
B_DRV: R127.1, U125.4 (Y)
B_EN: R126.1, U124.4 (Y), U125.1 (OE), U126.2 (B)
B_RX: U126.4 (Y); also elsewhere on the board
B_SENSE: R128.2, U126.1 (A)
B_TX: U125.2 (B); also elsewhere on the board
B_TXDEN: R125.1, U124.1 (A); also elsewhere on the board
FT_PWREN_N: U120.2 (B); also elsewhere on the board
FT_READY: U120.4 (Y), U121.2 (B), U124.2 (B)
GND: C140.2, C141.2, C142.2, C143.2, C144.2, C145.2, C146.2, C147.2, C148.2, D120.2, D121.2, J120.3, J121.3, R120.2, R121.2, R125.2, R126.2, U120.3 (GND), U121.3 (GND), U122.3 (GND), U123.3 (GND), U124.3 (GND), U125.3 (GND), U126.3 (GND); also elsewhere on the board
VBAT_IN: F120.1, F121.1; also elsewhere on the board
VPH_A: C147.1, F120.2, J120.2
VPH_B: C148.1, F121.2, J121.2

Notes on the sheet:
Matching global net labels connect across sheets. Unused pins are marked NC.
Ground is common; servo +3S is separate from logic +5V. See README for unresolved electrical and mechanical checks.
