eugenewang5425/MicroDinosaur/hardware/head_hat/kicad/HEAD_A0.kicad_pcb

## KiCad design hardware/head_hat/kicad/HEAD_A0.kicad_pcb (continued)

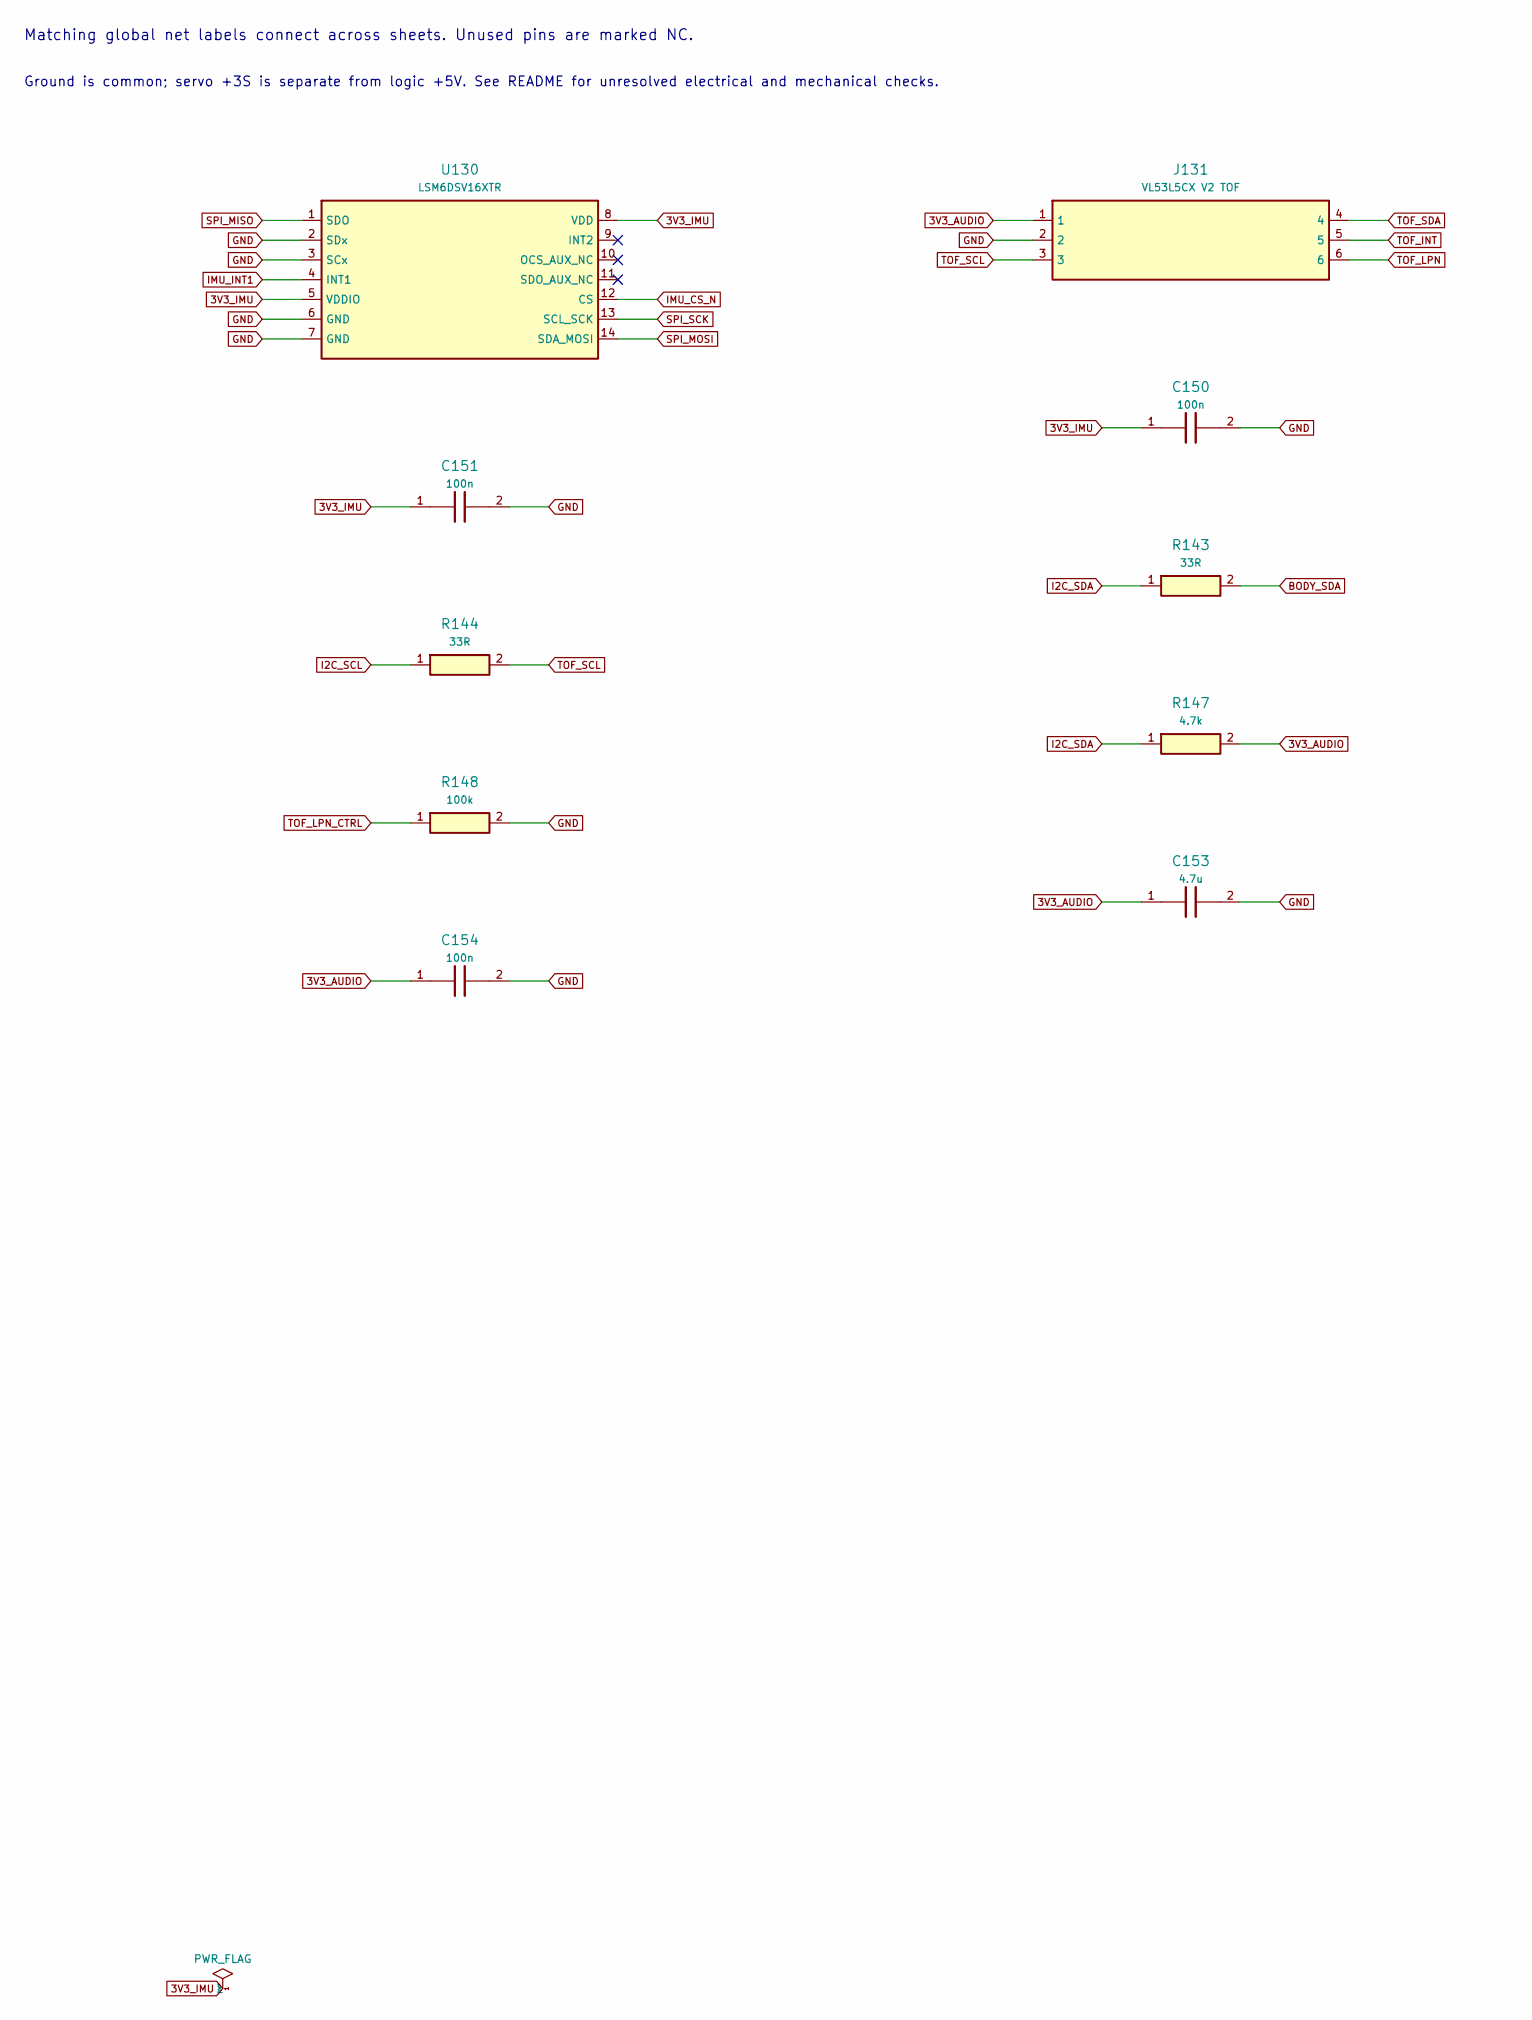
[picture p30: schematic 06_Sensors.kicad_sch, 06_Sensors | HEAD B2 / 65x30mm / 6L, part in row 1, column 1]

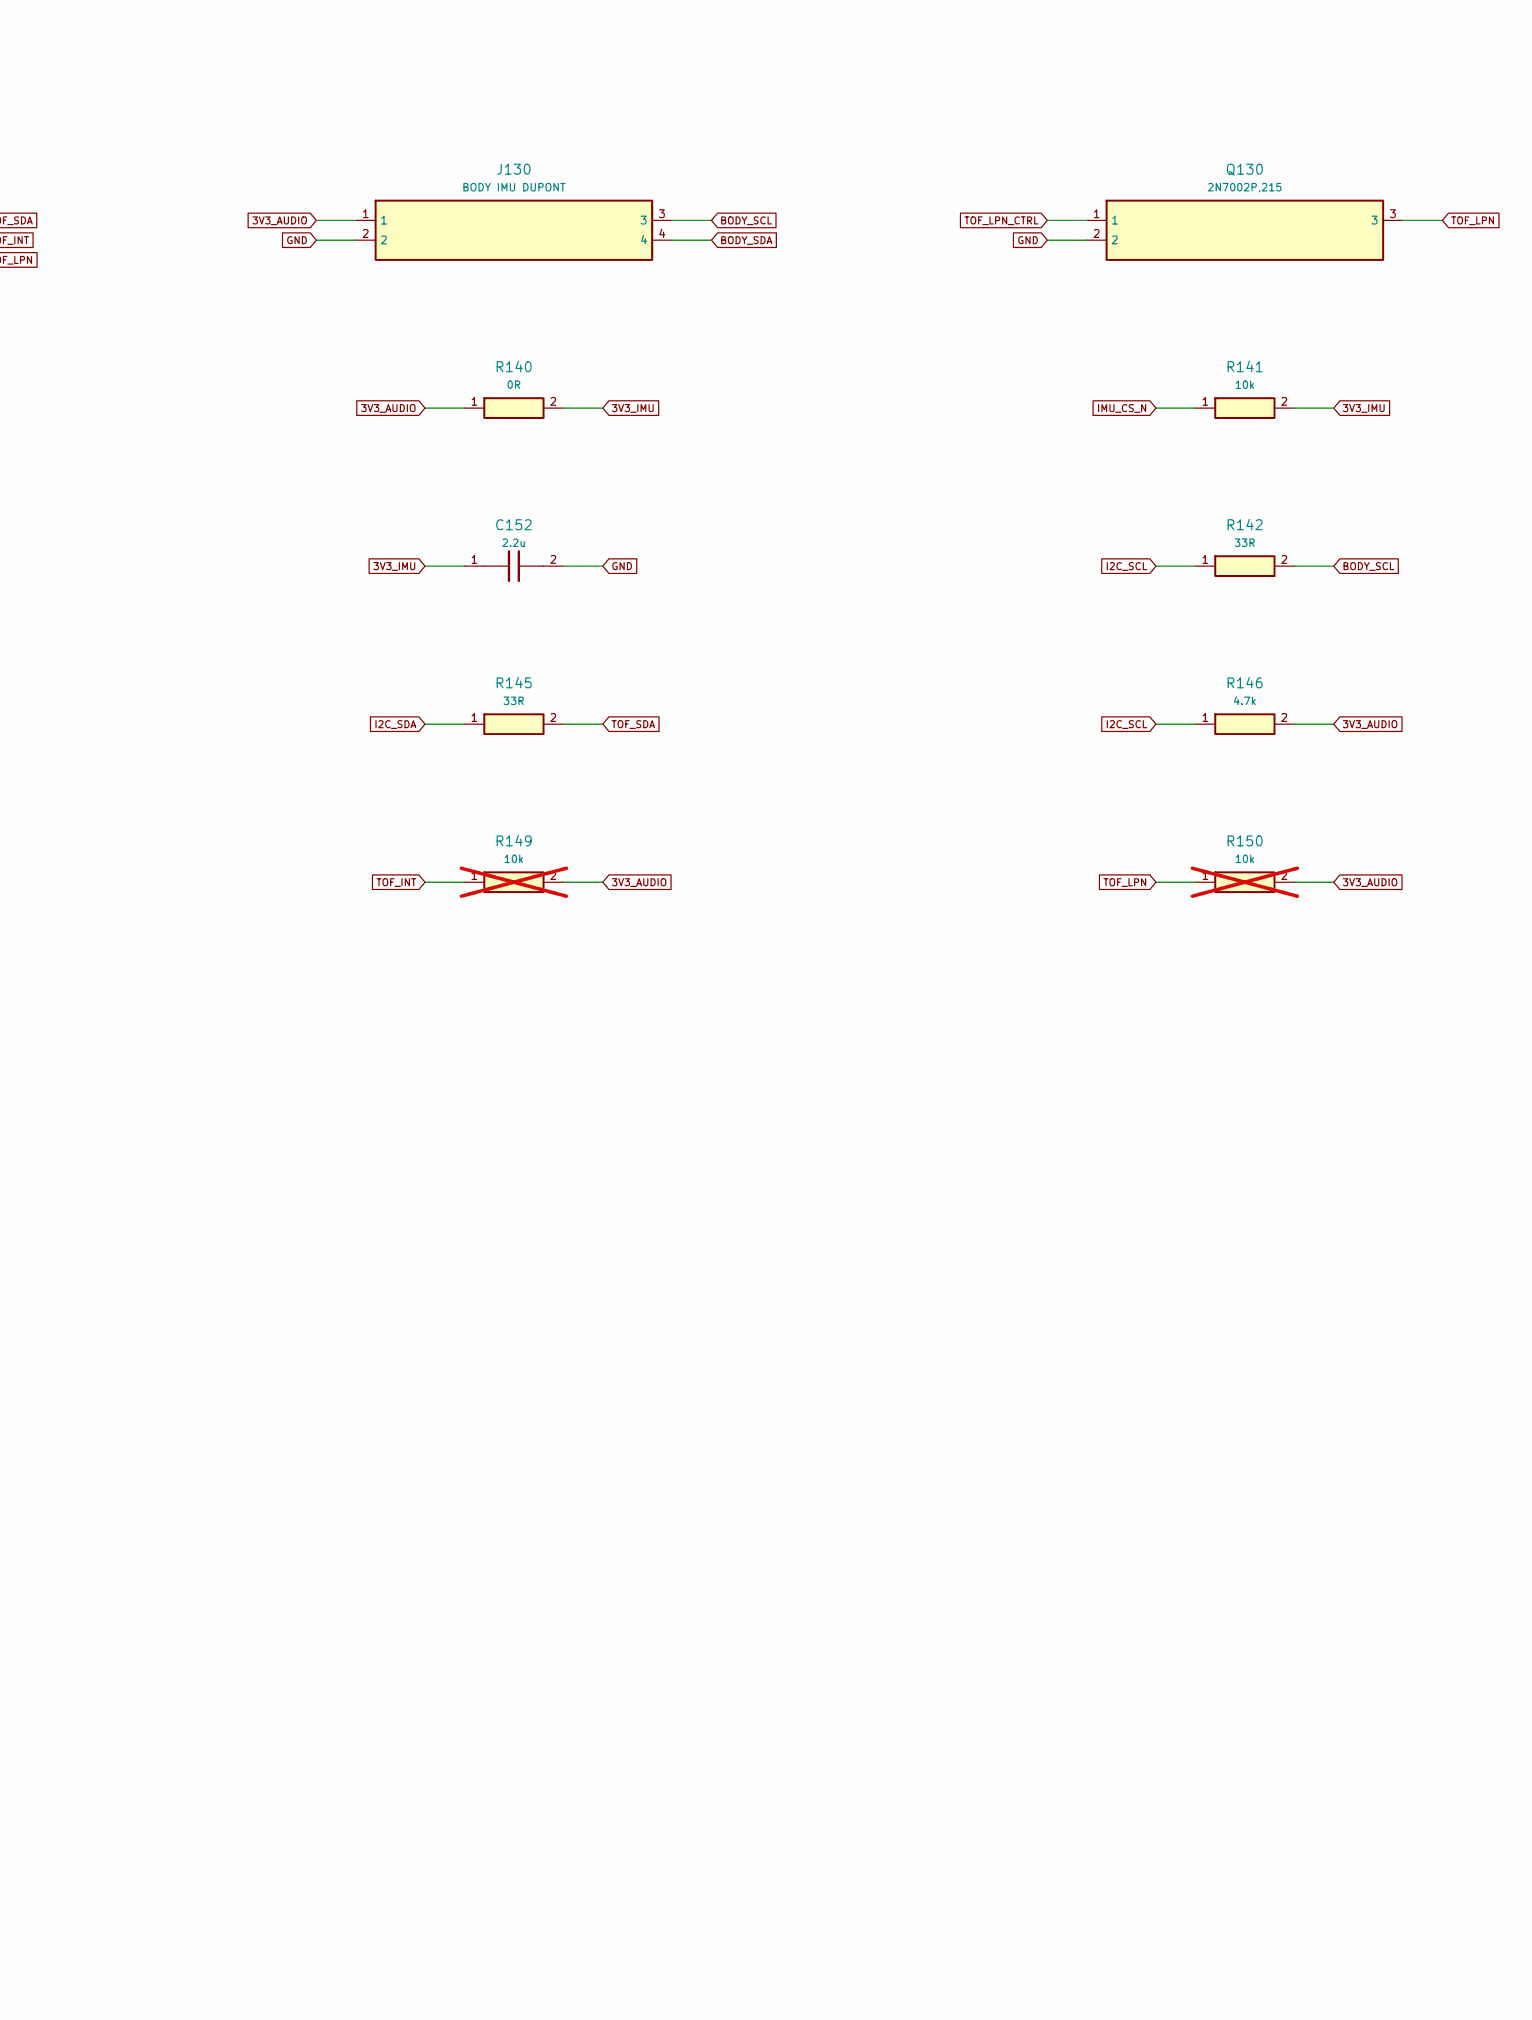
[picture p31: schematic 06_Sensors.kicad_sch, 06_Sensors | HEAD B2 / 65x30mm / 6L, part in row 1, column 2]

Parts:
C150, C151, C154: 100n; Capacitor_SMD__C_0402_1005Metric; MPN GRM155R71C104KA88D
C152: 2.2u; Capacitor_SMD__C_0402_1005Metric; MPN GRM155R60J225ME95D
C153: 4.7u; Capacitor_SMD__C_0603_1608Metric; MPN GRM188R60J475KE19D
J130: BODY IMU DUPONT; Connector_PinHeader_2.54mm__PinHeader_1x04_P2.54mm_Vertical; MPN 61300411121
J131: VL53L5CX V2 TOF; Connector_PinHeader_2.54mm__PinHeader_1x06_P2.54mm_Vertical; MPN 61300611121
Q130: 2N7002P,215; Package_TO_SOT_SMD__SOT-23; MPN 2N7002P,215
R140: 0R; Resistor_SMD__R_0402_1005Metric; MPN RC0402JR-070RL
R141: 10k; Resistor_SMD__R_0402_1005Metric; MPN RC0402FR-0710KL
R142, R143, R144, R145: 33R; Resistor_SMD__R_0402_1005Metric; MPN RC0402FR-0733RL
R146, R147: 4.7k; Resistor_SMD__R_0402_1005Metric; MPN RC0402FR-074K7L
R148: 100k; Resistor_SMD__R_0402_1005Metric; MPN RC0402FR-07100KL
R149, R150: 10k; Resistor_SMD__R_0402_1005Metric; MPN RC0402FR-0710KL; not fitted
U130: LSM6DSV16XTR; Package_LGA__LGA-14_3x2.5mm_P0.5mm_LayoutBorder3x4y; MPN LSM6DSV16XTR

Connections:
3V3_AUDIO: C153.1, C154.1, J130.1, J131.1, R140.1, R146.2, R147.2, R149.2, R150.2; also elsewhere on the board
3V3_IMU: C150.1, C151.1, C152.1, R140.2, R141.2, U130.5 (VDDIO), U130.8 (VDD)
BODY_SCL: J130.3, R142.2
BODY_SDA: J130.4, R143.2
GND: C150.2, C151.2, C152.2, C153.2, C154.2, J130.2, J131.2, Q130.2, R148.2, U130.2 (SDx), U130.3 (SCx), U130.6 (GND), U130.7 (GND); also elsewhere on the board
I2C_SCL: R142.1, R144.1, R146.1; also elsewhere on the board
I2C_SDA: R143.1, R145.1, R147.1; also elsewhere on the board
IMU_CS_N: R141.1, U130.12 (CS); also elsewhere on the board
IMU_INT1: U130.4 (INT1); also elsewhere on the board
SPI_MISO: U130.1 (SDO); also elsewhere on the board
SPI_MOSI: U130.14 (SDA_MOSI); also elsewhere on the board
SPI_SCK: U130.13 (SCL_SCK); also elsewhere on the board
TOF_INT: J131.5, R149.1; also elsewhere on the board
TOF_LPN: J131.6, Q130.3, R150.1
TOF_LPN_CTRL: Q130.1, R148.1; also elsewhere on the board
TOF_SCL: J131.3, R144.2
TOF_SDA: J131.4, R145.2

Notes on the sheet:
Matching global net labels connect across sheets. Unused pins are marked NC.
Ground is common; servo +3S is separate from logic +5V. See README for unresolved electrical and mechanical checks.

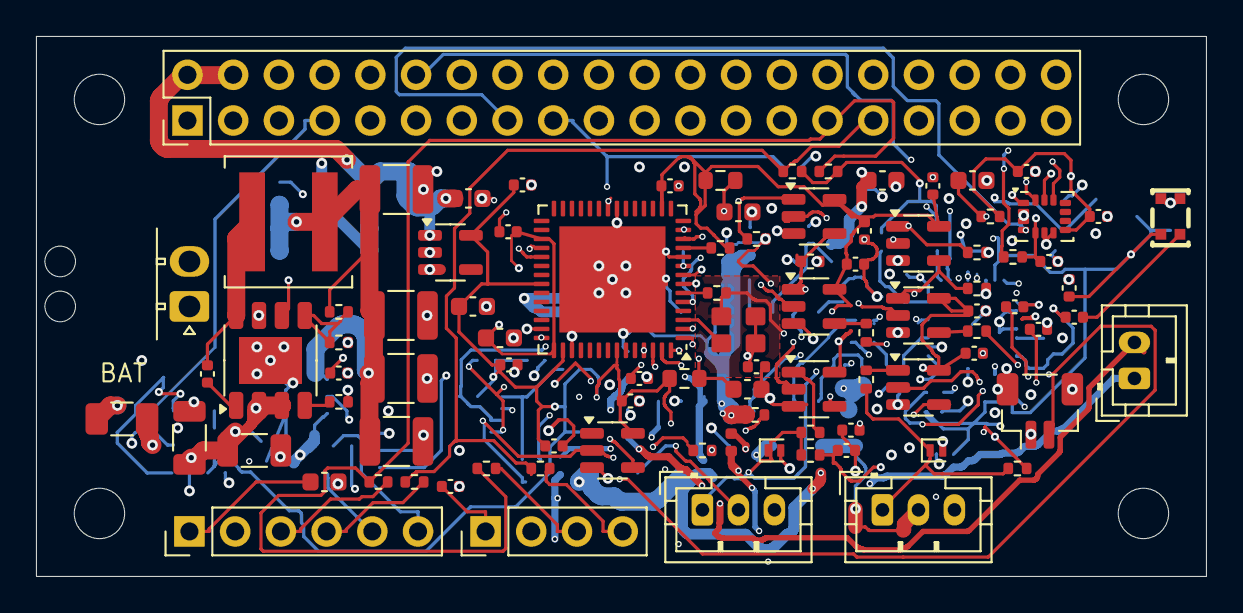
[picture p32: board HEAD_A0.kicad_pcb from above]

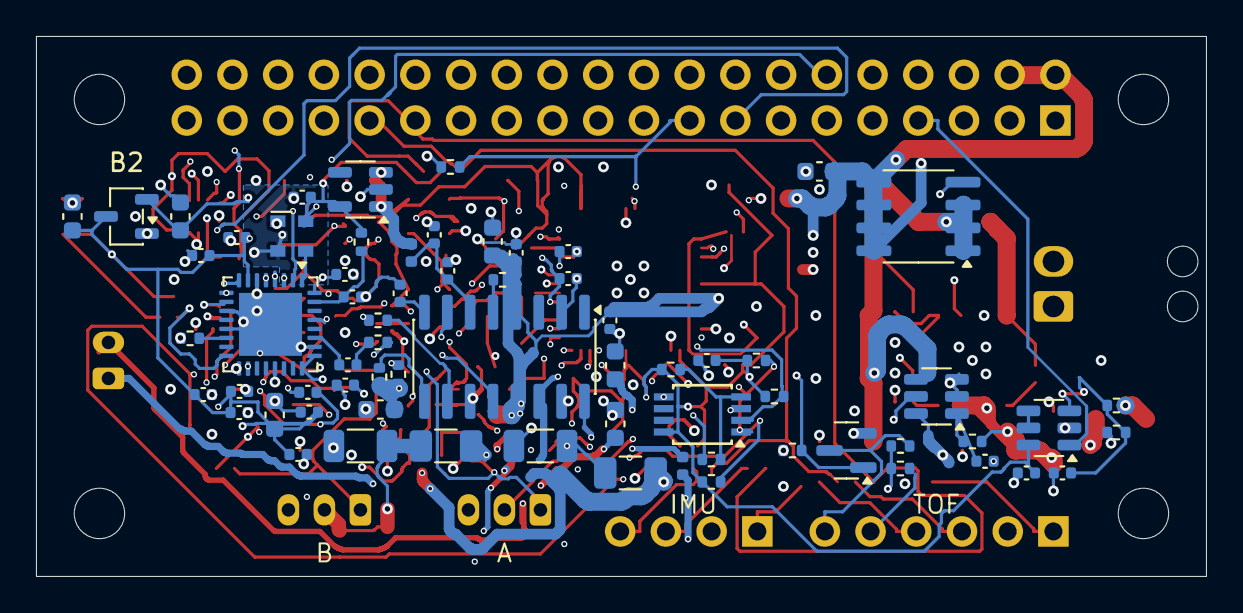
[picture p33: board HEAD_A0.kicad_pcb from below]

Board: 6 copper layers, 65.0 x 30.0 mm, 163 parts (67 on the bottom side), 91 nets.

Other parts of the board:
H1, H2, H3, H4: 2.8mm M2.5; MountingHole_2.7mm_M2.5
