eugenewang5425/MicroDinosaur/(commit log)

2026-09-13 Organize current MicroDinosaur v1 v07 CAD and modeling tools
    [fastener_interface_schedule.csv, parts_mass_estimate.csv]
2026-09-20 Publish MicroDinosaur simulation source and verified project evidence
    Preserve the current CAD while adding the local training snapshot, selected policies and results, portable CPU head-control replay, and explicit hardware validation limits.
    [conditions.csv]
2026-11-07 Publish latest OS-M02 model and current hardware software
    Keep only current deliverables on main; replace obsolete v07 packages with the matching CAD, native print project, HAT candidate, IMU probes and perception runtime. Preserve upstream notices and document pending physical validation.
2026-11-07 Keep the perception page linked to current release documentation
2026-11-08 Publish latest whole-body zero calibration fixture
2026-11-08 Remove unrequested whole-robot assembly 3MF export
